quibot-dev/QuiBot_IA-3Dmechatronic/hardware/electronics/README.md

# Electrònica

Aquesta carpeta conté els esquemes elèctrics de Quibot, elaborats amb KiCad 10 i exportats també en PDF.

El prototip utilitza mòduls comercials i cablejat punt a punt. No s'ha dissenyat una PCB pròpia i, per tant, no hi ha fitxers Gerber.
