quibot-dev/QuiBot_IA-3Dmechatronic/hardware/Cad/STL/README.md

Aquí es troben els fitxers STL del conjunts del robot.
