quibot-dev/QuiBot_IA-3Dmechatronic/hardware/Cad/README.md

Aquí es troben els fitxers necessaris per la creació del robot.
