quibot-dev/QuiBot_IA-3Dmechatronic/docs/Imatges/Conjunts Robot.png

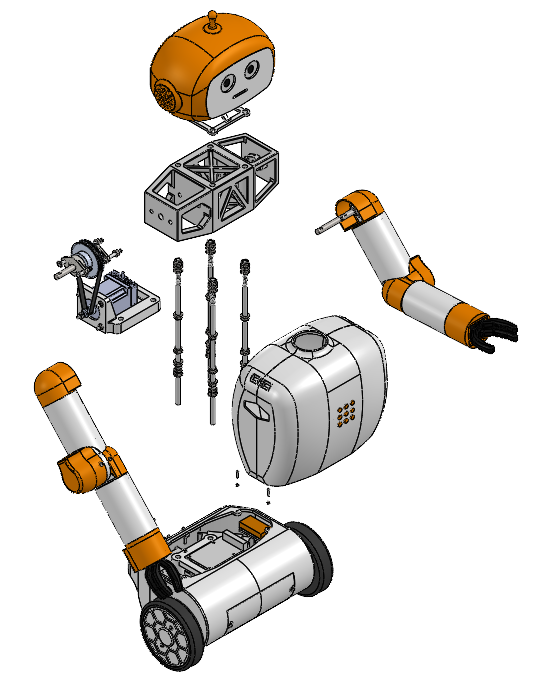
docs/Imatges/Conjunts Robot.png
