quibot-dev/QuiBot_IA-3Dmechatronic/bom/ Llista de materials de compra/Material de compra.csv

Categoria/Concepte | Quantitat | Cost unitari (€) | Cost Total (€) | Ref.
Processament i Control
Raspberry Pi 4 Model B 4 GB | 1 | 108,95 | 108,95 | https://www.tiendatec.es/raspberry-pi/gama-raspberry-pi/1100-raspberry-pi-4-modelo-b-4gb-5056561800349.html
MicroSD | 1 | 17,48 | 17,48 | https://www.amazon.es/-/en/SanDisk-Ultra-microSDHC-Adapter-100MB/dp/B08HVWJM8C
Arduino Uno Rev3 | 1 | 29,3 | 29,3 | https://www.amazon.es/Arduino-UNO-A000066-microcontrolador-ATmega328/dp/B008GRTSV6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
Sensors i Interfície
DualEye | 1 | 26,99 | 26,99 | https://www.amazon.es/-/en/Waveshare-Development-Resolution-Dual-Core-Processor/dp/B0FQ58T5VS
Mòdul de Micròfon (ReSpeaker) | 1 | 31,11 | 31,11 | https://www.mouser.es/ProductDetail/Seeed-Studio/110061601?qs=efUn273yAhcPxUjBpI0kHA%3D%3D&mgh=1&vip=1
Altaveu | 1 | 9,99 | 9,99 | https://www.amazon.es/Digitalkey-completo-pulgadas-cuadrado-frecuencia/dp/B0GL36Q9HS
Motors
Stepper Nema 23 | 1 | 31,22 | 31,22 | https://www.amazon.es/STEPPERONLINE-Nema-23-Motor-bipolar/dp/B00PNEPI0A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
Stepper Nema 17 | 2 | 16,94 | 33,88 | https://www.amazon.es/Stepper-Bipolar-4-lead-Printer-STEPPERONLINE/dp/B00PNEQKC0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
Servomotor 15kg·cm | 1 | 45,97 | 45,97 | https://www.amazon.es/ANNIMOS-Direcci%C3%B3n-Digital-Engranaje-Inoxidable/dp/B0C69BXL6V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
Servomotor 15Kg·cm (2u.) | 1 | 15,99 | 15,99 | https://www.amazon.es/Miuzei-Servomotor-Accuracy-Airplane-Helicopter/dp/B0C1TXW74L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
Drivers i Distribució de Potència
Driver Steppers (TB6600) | 3 | 10,89 | 32,67 | https://www.amazon.es/COVVY-TB6600-Controlador-segmentos-Conductor/dp/B07SBZ9SM5
Placa de distribució (PDB) | 1 | 23,59 | 23,59 | https://rc-innovations.es/shop/fchub-12s-placa-potencia-xclass-matek-fchub-12s-v2-440a-bec-5v-12v-11108
Convertidor Buck (Arduino i servos) | 2 | 5,99 | 11,98 | https://www.amazon.es/XL4015-Convertidor-ajustable-CC-CV/dp/B0D9HPY6J6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
UBEC servo | 1 | 18,79 | 18,79 | https://es.aliexpress.com/item/1005008564508622.html?src=google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
Alimentació
Bateria | 1 | 49,99 | 49,99 | https://www.amazon.es/DXF-14-8V-Bater%C3%ADa-6500mah-Conector/dp/B09KP6T2RC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
Carregador bateria | 1 | 36,99 | 36,99 | https://www.amazon.es/Cargador-bater%C3%ADa-B6-Adaptador-Plomo-%C3%A1cido/dp/B0F2H3XR6S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
Alarma bateria | 1 | 6,99 | 6,99 | https://www.amazon.es/QC-Battery-Monitor-Zumbador-indicador/dp/B077Z1N9CS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
Cablejat i Protecció
Cable AWG16 | 1 | 12,99 | 12,99 | https://www.amazon.es/Silicona-Alambres-El%C3%A9ctricos-Conductor-paralelo/dp/B07QJFRYT8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
Cable AWG18 | 1 | 19,79 | 19,79 | https://www.amazon.es/MMOBIEL-AWG-Cable-El%C3%A9ctrico-Paralelo/dp/B0DGV6793J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
Cable AWG24 | 1 | 8,99 | 8,99 | https://www.amazon.es/URCIANOW-El%C3%A9ctrico-Conductores-trenzado-esta%C3%B1ado/dp/B0CH9X7X6L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
Cable Dupont (mascle-femella) | 3 | 6,5 | 19,5 | https://www.amazon.es/TECHZOCO-alambre-Prototipo-Raspberry-Breadboard/dp/B0DLR85XS5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
Cable USB-A a USB-C (1m) | 2 | 7,8 | 15,6 | https://www.amazon.es/deleyCON-USB-USB-C-Cable-5Gbps/dp/B0GVKJJ3QN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
Cable USB-A a USB-B (1m) | 1 | 6,95 | 6,95 | https://www.amazon.es/deleyCON-Printer-Printers-Scanners-Braided/dp/B0DGW5V48J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
Cable d’alimentació Raspberry | 1 | 3,97 | 3,97 | https://www.reichelt.com/es/es/shop/producto/raspberry_pi_-_cable_de_alimentacion_usb-c_max_5_a_1_m-405496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
Fusible | 1 | 0,5 | 0,5 | *
Portafusibles | 1 | 3 | 3 | *
Terminal Faston | 2 | 1 | 2 | *
Concepte | Quantitat | Preu unitari (€) | Import (€) | Ref.
Transmissió i Moviment
Rodament 40x52x7mm | 1 | 10,09 | 10,09 | https://www.amazon.es/dp/B0CL4XF6HH?aref=ggrQ3vEDTD&sp_csd=d2lkZ2V0TmFtZT1zcF9kZXRhaWxfdGhlbWF0aWM
Rodament amb brida (2u.) | 1 | 11,51 | 11,51 | https://www.amazon.es/Rodamientos-Cojinetes-Cojinete-Maquinaria-Transporte/dp/B0DJ3G4DZ4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
Politja GT2 20D (Ø int. 6,35mm) | 1 | 6,47 | 6,47 | https://www.amazon.es/Alamor-Sincronizaci%C3%B3n-20Teeth-Di%C3%A1metro-Impresora/dp/B076P75NGK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
Politja GT2 100D (Ø int. 10mm) | 1 | 26,62 | 26,62 | https://www.amazon.es/dentada-distribuci%C3%B3n-di%C3%A1metro-s%C3%ADncrona-impresora/dp/B0D3CDWB7C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
Corretja GT2 10mm, 348mm | 1 | 8,49 | 8,49 | https://www.amazon.es/Turmberg3D-Correa-dentada-cerrada-GT2/dp/B09B2GK13C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
Eix 10x100mm | 1 | 7 | 7 | https://www.amazon.es/unidades-horizontal-precisi%C3%B3n-rodamiento-redonda/dp/B0D2L12GW6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
Rodes Giratòries Autoadhesives | 1 | 6,99 | 6,99 | https://www.amazon.es/Flintronic-Giratorias-Autoadhesivas-Tornillos-Adhesivos/dp/B0DXB4NJPG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
Cargoleria i Fixació
Acoblament 10mm | 1 | 1,25 | 1,25 | https://handsontec.com/index.php/product/shf10-horizontal-linear-shaft-holder/
Acoblament brida 10 mm | 1 | 11,99 | 11,99 | https://www.amazon.es/dp/B0FXR72L42?smid=A3KRCRBQV8XOTV&ref_=chk_typ_imgToDp&th=1
Acoblament rodes | 2 | 8,49 | 16,98 | https://www.amazon.es/dp/B09XMC7YMY/ref=cm_cr_arp_d_btm?ie=UTF8
Barra roscada M8 x 300 mm( 4u.) | 1 | 15,99 | 15,99 | https://www.amazon.es/Varilla-Roscada-Acero-Inoxidable-M8x300mm/dp/B0H9S17NXH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
Paquet d’Inserts de Llautó | 1 | 31,99 | 31,99 | https://www.amazon.es/dp/B0FQ2J8FX7?aref=3WEpV6r98c&sp_csd=d2lkZ2V0TmFtZT1zcF9kZXRhaWw
Cargols (Assortiment genèric) | 1 | 14,99 | 14,99 | https://www.amazon.es/tornillos-hexagonales-arandelas-roscados-Phillips/dp/B0B42DJPHZ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
Cargols M3 x 25mm | 1 | 6,99 | 6,99 | https://www.amazon.es/Tornillos-M3-Hexagonal-Cil%C3%ADndricaTornillos-Inoxidable/dp/B0F8R4RT7N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
Cargols de ressalt 4 x 45 x M3 x 0,5 | 1 | 13,07 | 13,07 | https://www.amazon.es/sourcing-map-inoxidable-industrias-maquinaria/dp/B0FDQ919CL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
Femelles M8 | 1 | 9,59 | 9,59 | https://www.amazon.es/GUEEYUAW-Piezas-Tuercas-Hexagonales-Inoxidable/dp/B0FHBH3MD1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
Femelles autoblocants M8 | 1 | 11,9 | 11,9 | https://www.amazon.es/dp/B0FV3MFBQG?ref=ppx_yo2ov_dt_b_fed_asin_title
Materials de Fabricació i Consumibles
Filament 3D | 5 kg | 29/kg | 145 | https://bcn3d.com/es/producto/pla-bcn3d-filamentos-2/
Estany per soldar | 1 | 10,99 | 10,99 | https://www.amazon.es/HUAREW-HR990307-alambre-soldadura-colofonia/dp/B08CRNHLKV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
Cinta rodes | 1 | 15,39 | 15,39 | *
Total | 897,04
