quibot-dev/QuiBot_IA-3Dmechatronic/bom/ Llista de materials de compra/Material_de_compra.csv

Categoria/Concepte | Quantitat | Cost unitari (€) | Cost Total (€) | Ref.
Processament i Control
Raspberry Pi 4 Model B 4 GB | 1 | 108,95 | 108,95 | Link
MicroSD | 1 | 17,48 | 17,48 | Link
Arduino Uno Rev3 | 1 | 29,3 | 29,3 | Link
Sensors i Interfície
DualEye | 1 | 26,99 | 26,99 | Link
Mòdul de Micròfon (ReSpeaker) | 1 | 31,11 | 31,11 | Link
Altaveu | 1 | 9,99 | 9,99 | Link
Motors
Stepper Nema 23 | 1 | 31,22 | 31,22 | Link
Stepper Nema 17 | 2 | 16,94 | 33,88 | Link
Servomotor 15kg·cm | 1 | 45,97 | 45,97 | Link
Servomotor 15Kg·cm (2u.) | 1 | 15,99 | 15,99 | Link
Drivers i Distribució de Potència
Driver Steppers (TB6600) | 3 | 10,89 | 32,67 | Link
Placa de distribució (PDB) | 1 | 23,59 | 23,59 | Link
Convertidor Buck (Arduino i servos) | 2 | 5,99 | 11,98 | Link
UBEC servo | 1 | 18,79 | 18,79 | Link
Alimentació
Bateria | 1 | 49,99 | 49,99 | Link
Carregador bateria | 1 | 36,99 | 36,99 | Link
Alarma bateria | 1 | 6,99 | 6,99 | Link
Cablejat i Protecció
Cable AWG16 | 1 | 12,99 | 12,99 | Link
Cable AWG18 | 1 | 19,79 | 19,79 | Link
Cable AWG24 | 1 | 8,99 | 8,99 | Link
Cable Dupont (mascle-femella) | 3 | 6,5 | 19,5 | Link
Cable USB-A a USB-C (1m) | 2 | 7,8 | 15,6 | Link
Cable USB-A a USB-B (1m) | 1 | 6,95 | 6,95 | Link
Cable d’alimentació Raspberry | 1 | 3,97 | 3,97 | Link
Fusible | 1 | 0,5 | 0,5 | *
Portafusibles | 1 | 3 | 3 | *
Terminal Faston | 2 | 1 | 2 | *
Concepte | Quantitat | Preu unitari (€) | Import (€) | Ref.
Transmissió i Moviment
Rodament 40x52x7mm | 1 | 10,09 | 10,09 | Link
Rodament amb brida (2u.) | 1 | 11,51 | 11,51 | Link
Politja GT2 20D (Ø int. 6,35mm) | 1 | 6,47 | 6,47 | Link
Politja GT2 100D (Ø int. 10mm) | 1 | 26,62 | 26,62 | Link
Corretja GT2 10mm, 348mm | 1 | 8,49 | 8,49 | Link
Eix 10x100mm | 1 | 7 | 7 | Link
Rodes Giratòries Autoadhesives | 1 | 6,99 | 6,99 | Link
Cargoleria i Fixació
Acoblament 10mm | 1 | 1,25 | 1,25 | Link
Acoblament brida 10 mm | 1 | 11,99 | 11,99 | Link
Acoblament rodes | 2 | 8,49 | 16,98 | Link
Barra roscada M8 x 300 mm( 4u.) | 1 | 15,99 | 15,99 | Link
Paquet d’Inserts de Llautó | 1 | 31,99 | 31,99 | Link
Cargols (Assortiment genèric) | 1 | 14,99 | 14,99 | Link
Cargols M3 x 25mm | 1 | 6,99 | 6,99 | Link
Cargols de ressalt 4 x 45 x M3 x 0,5 | 1 | 13,07 | 13,07 | Link
Femelles M8 | 1 | 9,59 | 9,59 | Link
Femelles autoblocants M8 | 1 | 11,9 | 11,9 | Link
Materials de Fabricació i Consumibles
Filament 3D | 5 kg | 29/kg | 145 | PLA Filamento - BCN3D
Estany per soldar | 1 | 10,99 | 10,99 | Link
Cinta rodes | 1 | 15,39 | 15,39 | *
Total | 897,04
