quibot-dev/QuiBot_IA-3Dmechatronic/hardware/Cad/Step/Cos definitiu derrere.STEP

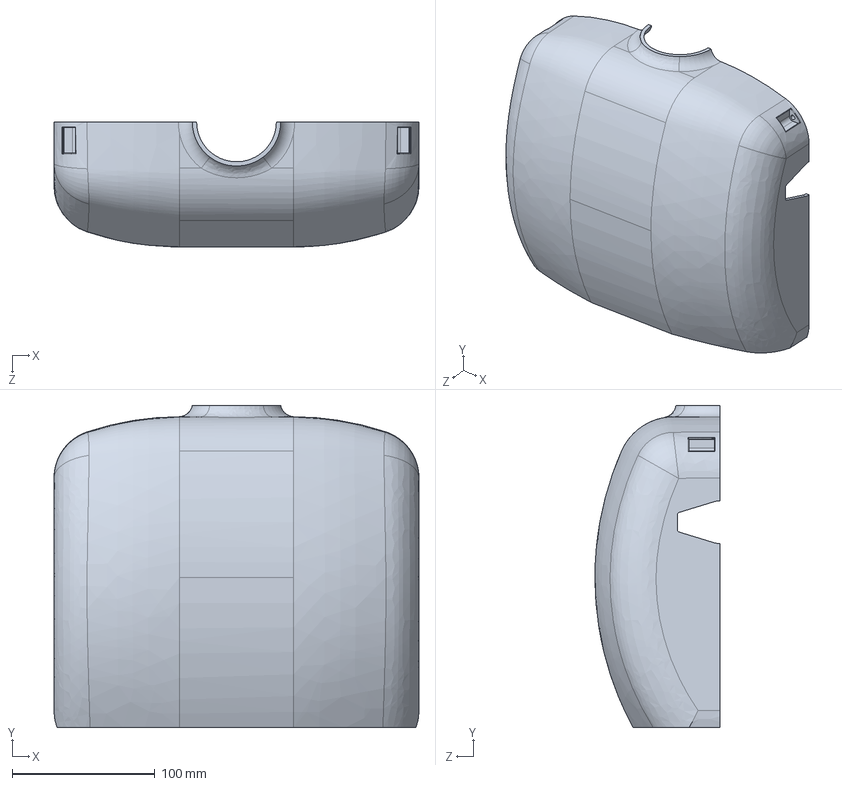
[picture p3: CAD file, 2026-10-04]
hardware/Cad/Step/Cos definitiu derrere.STEP
256.0 x 226.0 x 87.8 mm
