quibot-dev/QuiBot_IA-3Dmechatronic/hardware/Cad/Step/Roda.STEP

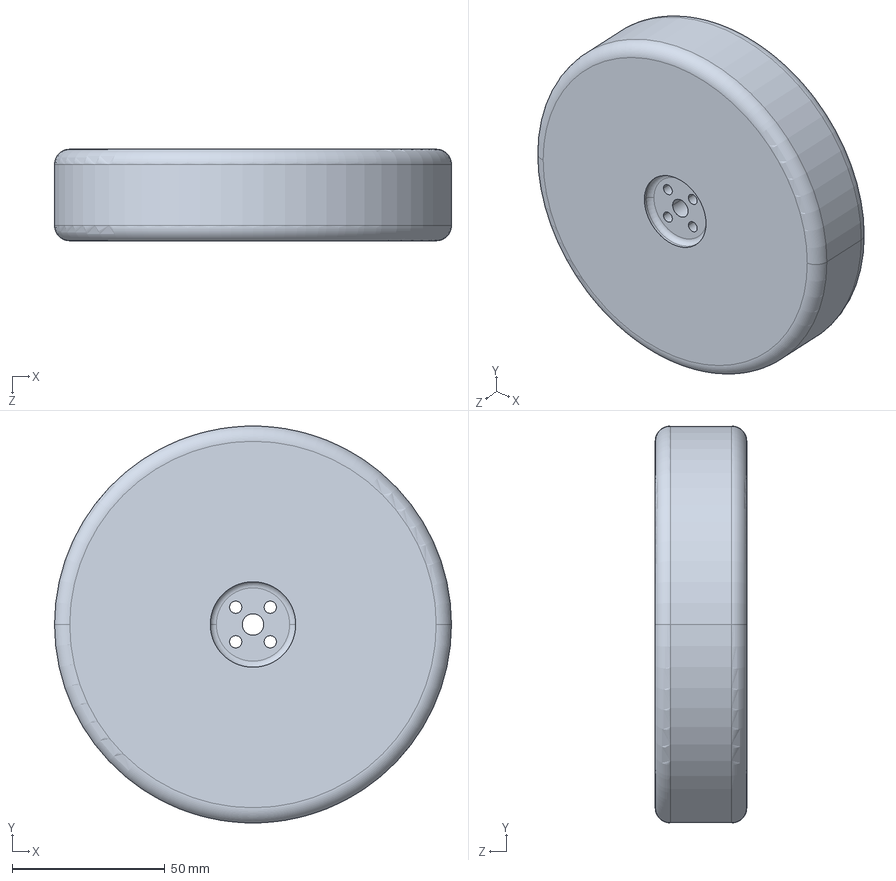
[picture p4: CAD file, 2026-10-04]
hardware/Cad/Step/Roda.STEP
130.0 x 129.9 x 30.0 mm
