quibot-dev/QuiBot_IA-3Dmechatronic/hardware/Cad/Step/Símbol upc.STEP

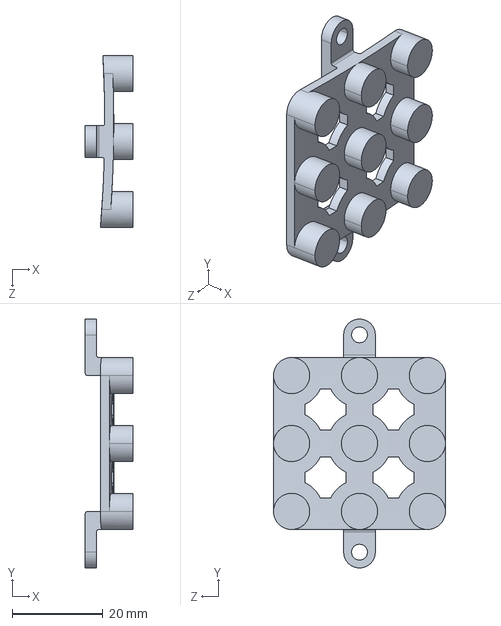
[picture p5: CAD file, 2026-10-04]
hardware/Cad/Step/Símbol upc.STEP
10.5 x 55.0 x 38.0 mm
