quibot-dev/QuiBot_IA-3Dmechatronic/hardware/Cad/Step/Base definitiva.STEP

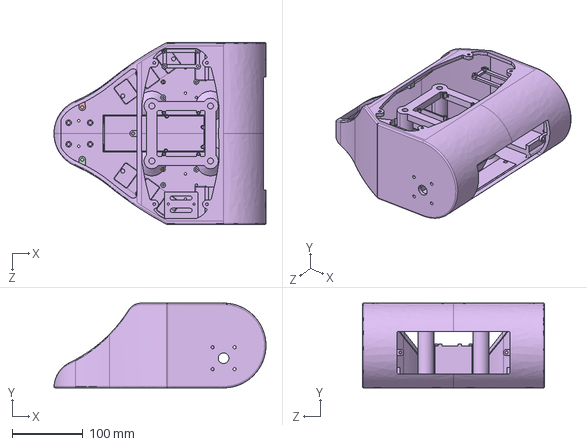
[picture p6: CAD file, 2026-10-04]
hardware/Cad/Step/Base definitiva.STEP
299.9 x 120.0 x 258.0 mm
