quibot-dev/QuiBot_IA-3Dmechatronic/hardware/Cad/Step/Primera tapa base.STEP

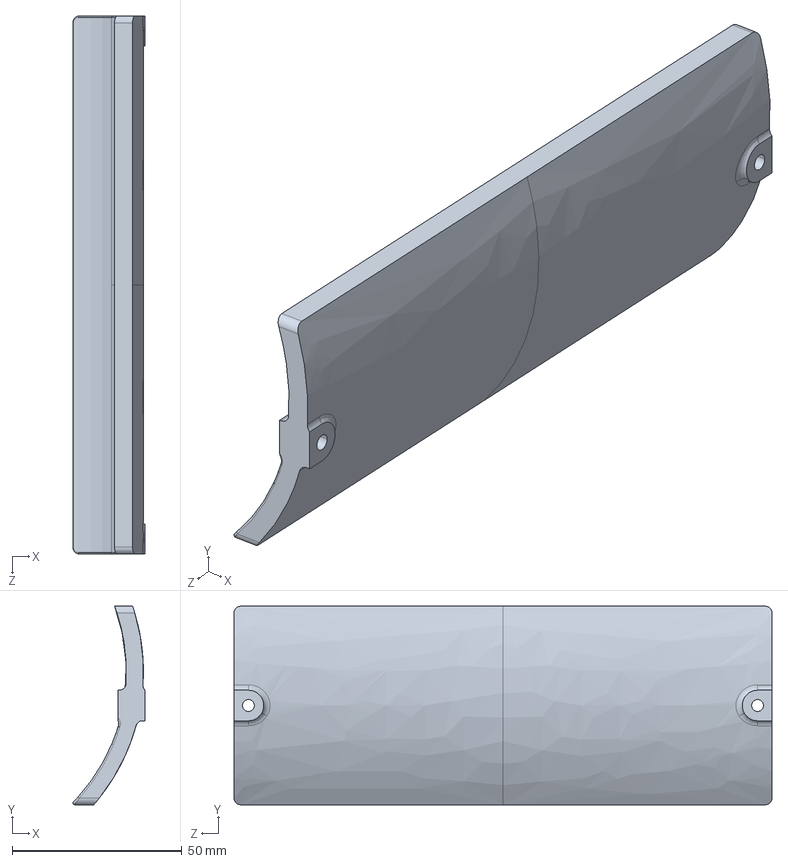
[picture p7: CAD file, 2026-10-04]
hardware/Cad/Step/Primera tapa base.STEP
21.3 x 58.5 x 158.5 mm
