quibot-dev/QuiBot_IA-3Dmechatronic/hardware/Cad/Step/Tapa_Roda.STEP

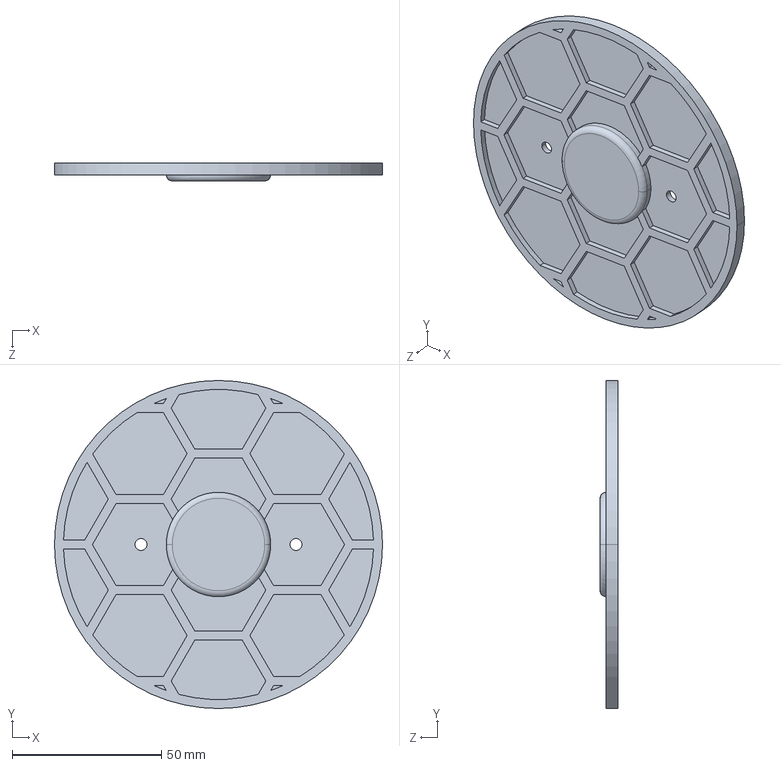
[picture p8: CAD file, 2026-10-04]
hardware/Cad/Step/Tapa_Roda.STEP
110.0 x 110.0 x 6.00 mm
