quibot-dev/QuiBot_IA-3Dmechatronic/hardware/Cad/Step/Cara.STEP

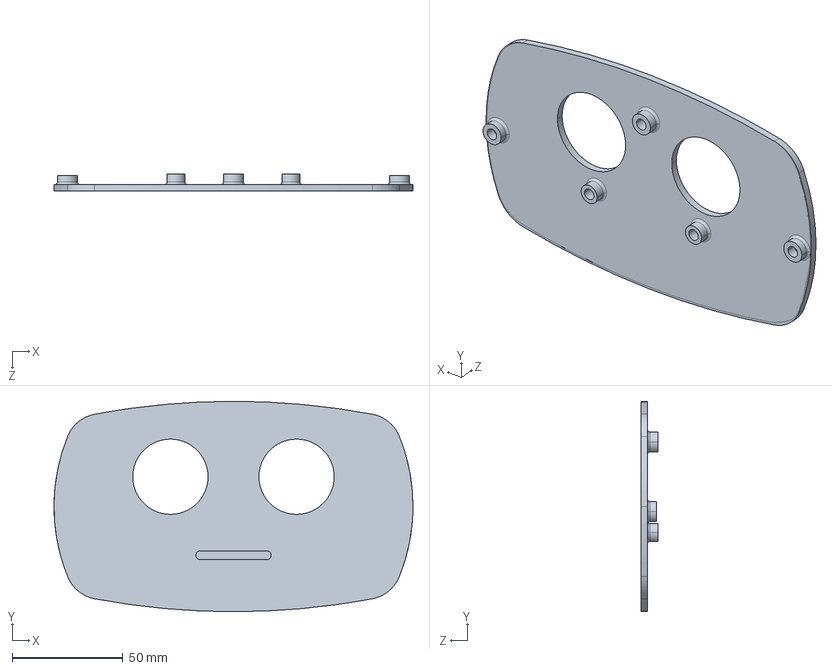
[picture p9: CAD file, 2026-10-04]
hardware/Cad/Step/Cara.STEP
162.2 x 95.0 x 7.71 mm
