quibot-dev/QuiBot_IA-3Dmechatronic/hardware/Cad/Step/Cap rectificat.STEP

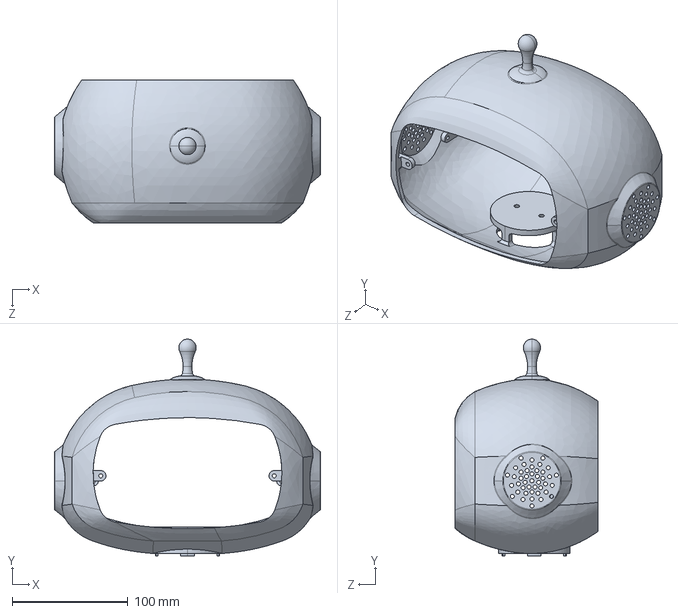
[picture p10: CAD file, 2026-10-04]
hardware/Cad/Step/Cap rectificat.STEP
230.0 x 187.5 x 123.4 mm
