quibot-dev/QuiBot_IA-3Dmechatronic/hardware/Cad/Step/Tapa posterior.STEP

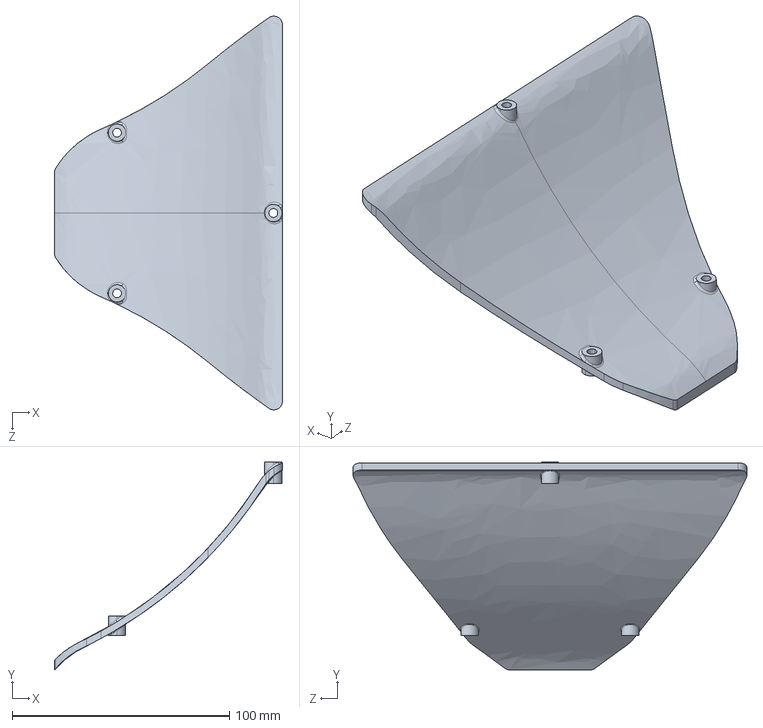
[picture p12: CAD file, 2026-10-04]
hardware/Cad/Step/Tapa posterior.STEP
105.0 x 95.8 x 181.3 mm
