quibot-dev/QuiBot_IA-3Dmechatronic/hardware/Cad/Step/Suport ulls.STEP

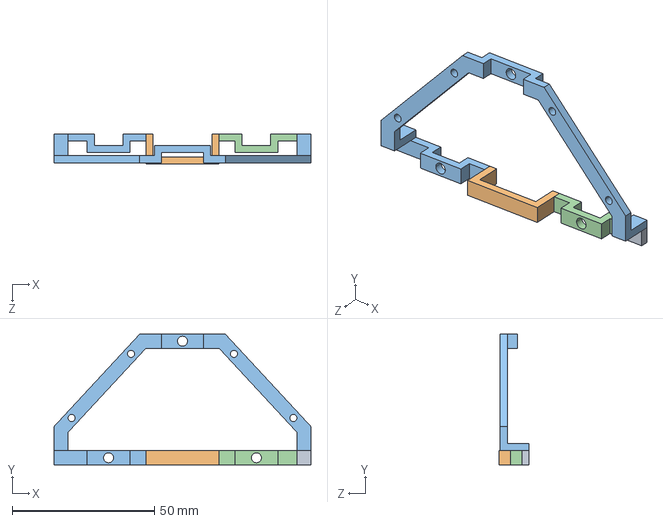
[picture p13: CAD file, 2026-10-04]
hardware/Cad/Step/Suport ulls.STEP
90.4 x 46.0 x 10.5 mm
