quibot-dev/QuiBot_IA-3Dmechatronic/hardware/Cad/Step/Suport cap.STEP

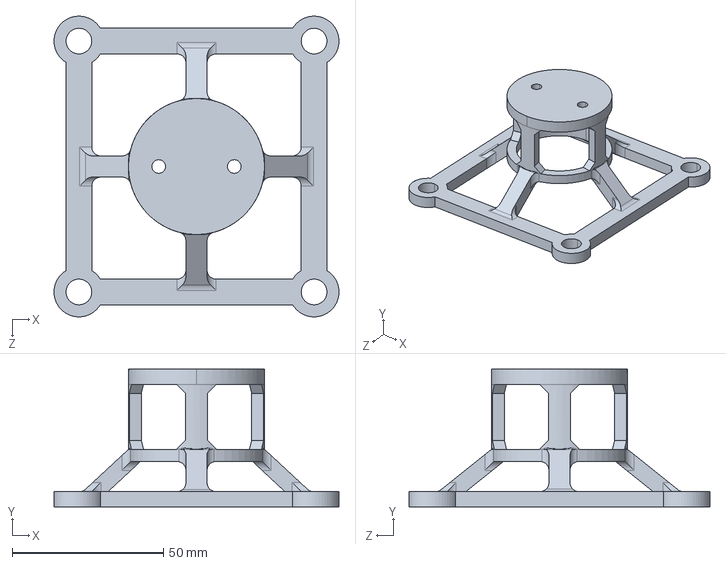
[picture p14: CAD file, 2026-10-04]
hardware/Cad/Step/Suport cap.STEP
94.3 x 45.5 x 99.5 mm
