quibot-dev/QuiBot_IA-3Dmechatronic/hardware/Cad/Step/Tapa posterior cap.STEP

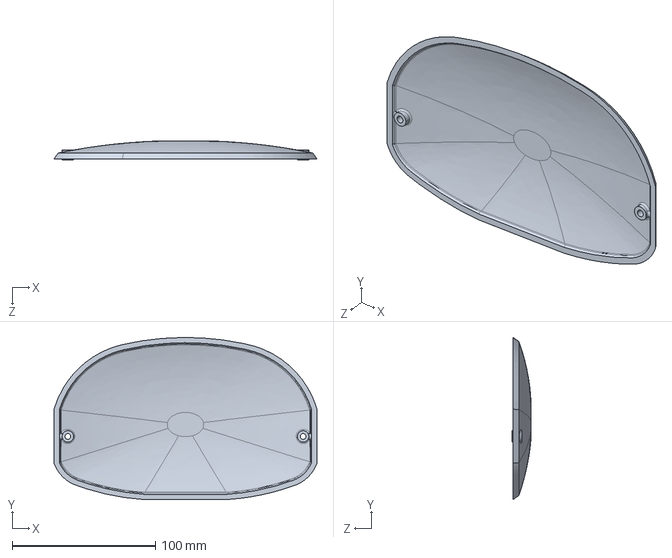
[picture p15: CAD file, 2026-10-04]
hardware/Cad/Step/Tapa posterior cap.STEP
183.3 x 113.0 x 13.6 mm
