quibot-dev/QuiBot_IA-3Dmechatronic/hardware/Cad/Step/Pinça interior braç esquerre.STEP

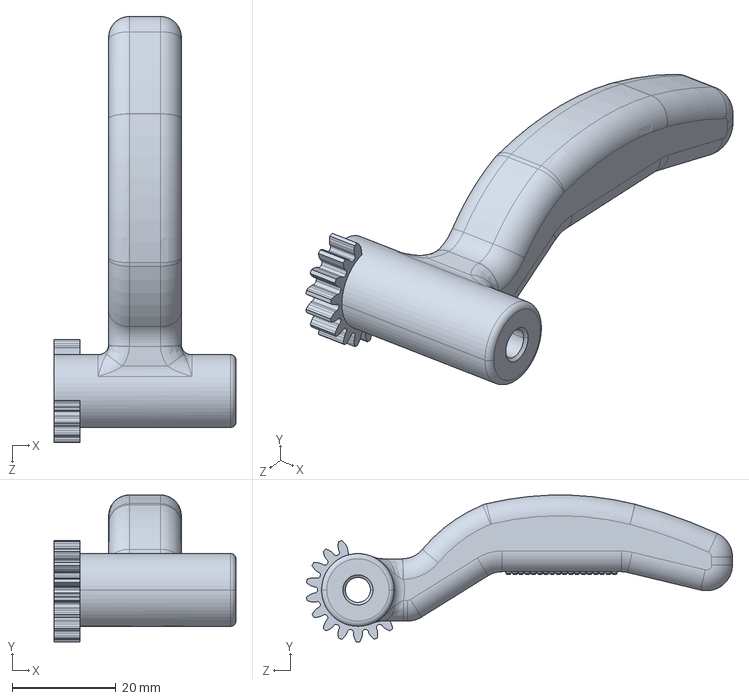
[picture p16: CAD file, 2026-10-04]
hardware/Cad/Step/Pinça interior braç esquerre.STEP
35.0 x 28.2 x 82.0 mm
