quibot-dev/QuiBot_IA-3Dmechatronic/hardware/Cad/Step/Colze interior esquerre.STEP

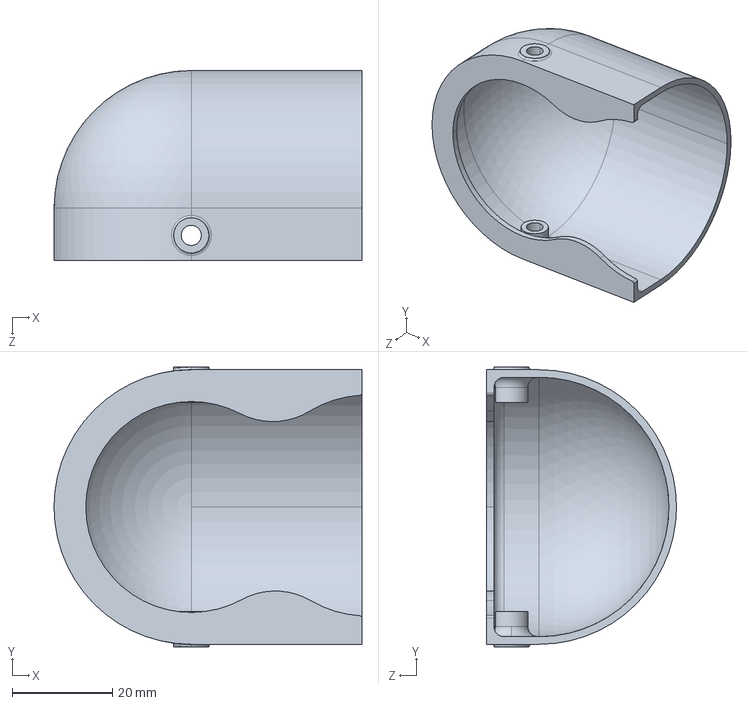
[picture p17: CAD file, 2026-10-04]
hardware/Cad/Step/Colze interior esquerre.STEP
61.3 x 55.7 x 37.8 mm
