quibot-dev/QuiBot_IA-3Dmechatronic/hardware/Cad/Step/Pinça exterior braç esquerre.STEP

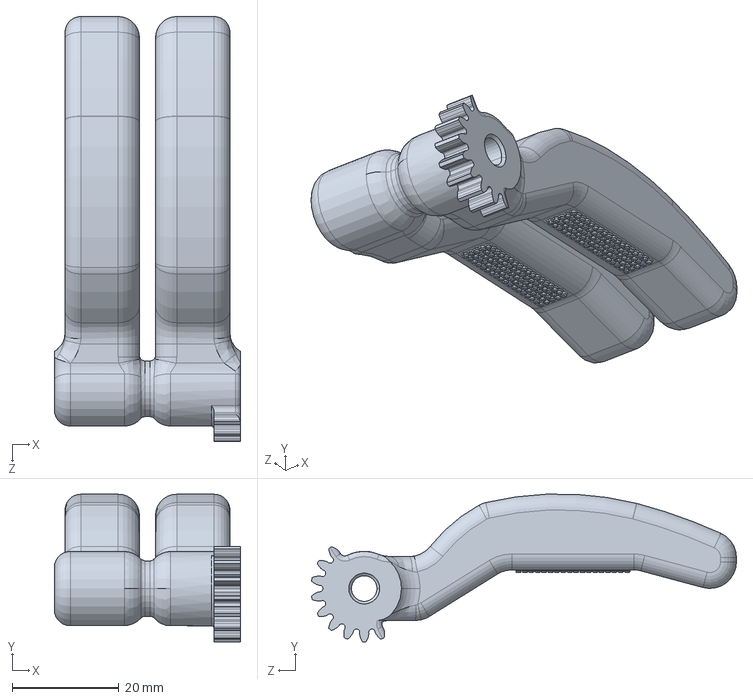
[picture p18: CAD file, 2026-10-04]
hardware/Cad/Step/Pinça exterior braç esquerre.STEP
35.0 x 27.7 x 79.8 mm
