quibot-dev/QuiBot_IA-3Dmechatronic/hardware/Cad/Step/Suport interior braços.STEP

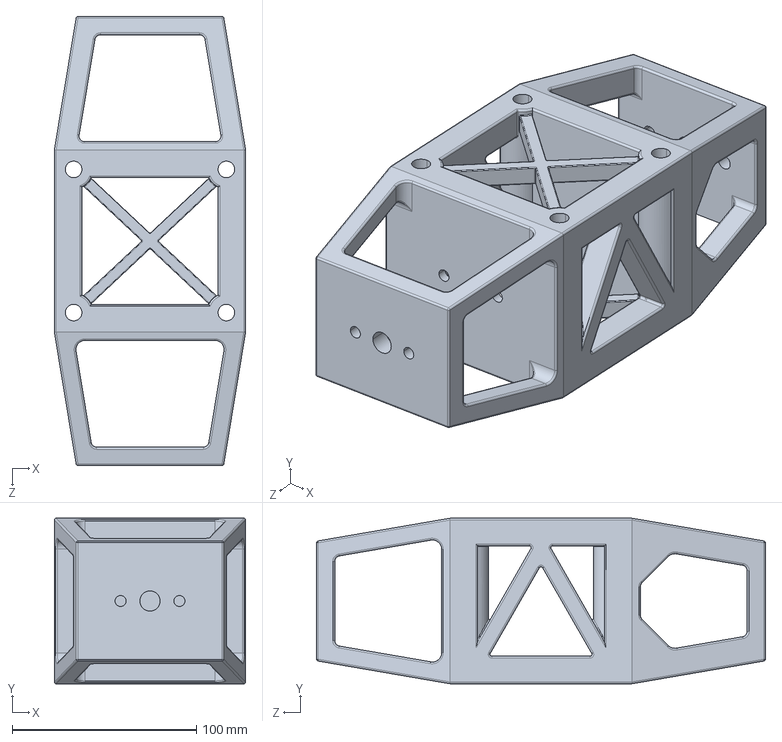
[picture p19: CAD file, 2026-10-04]
hardware/Cad/Step/Suport interior braços.STEP
104.0 x 90.0 x 244.0 mm
