quibot-dev/QuiBot_IA-3Dmechatronic/hardware/Cad/Step/Antebrazo braç esquerre.STEP

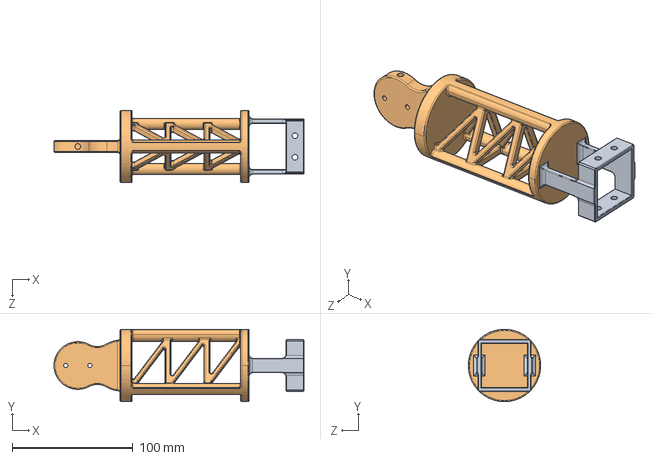
[picture p20: CAD file, 2026-10-04]
hardware/Cad/Step/Antebrazo braç esquerre.STEP
207.2 x 60.0 x 60.0 mm
