quibot-dev/QuiBot_IA-3Dmechatronic/hardware/Cad/Step/Tub principal braç esquerre.STEP

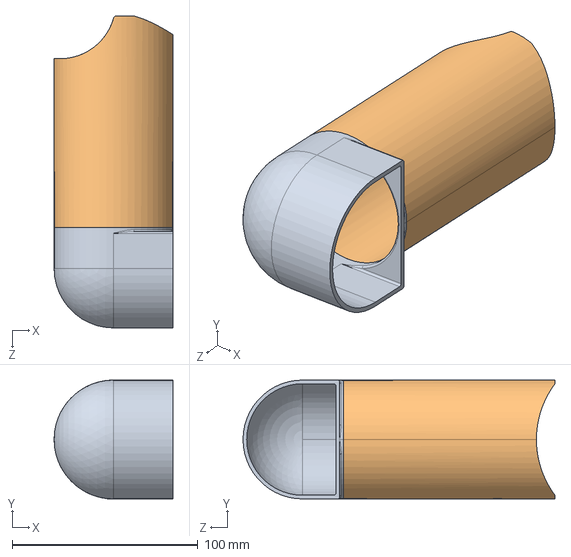
[picture p21: CAD file, 2026-10-04]
hardware/Cad/Step/Tub principal braç esquerre.STEP
64.0 x 64.0 x 168.0 mm
