quibot-dev/QuiBot_IA-3Dmechatronic/hardware/Cad/Step/Colze braç esquerre definitiu.STEP

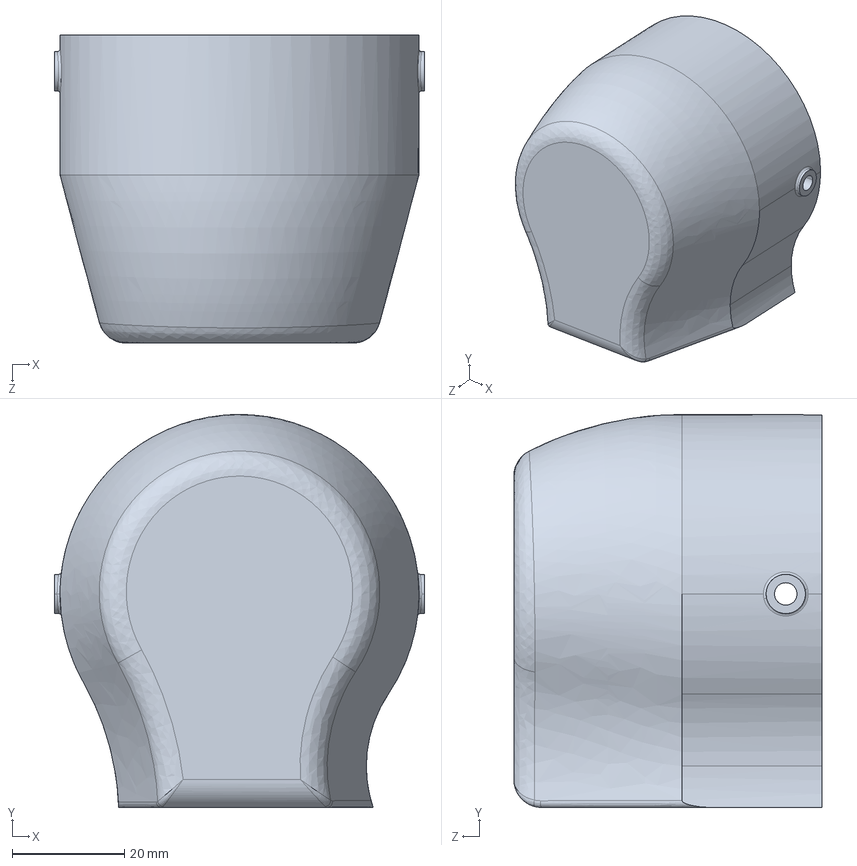
[picture p22: CAD file, 2026-10-04]
hardware/Cad/Step/Colze braç esquerre definitiu.STEP
66.0 x 70.1 x 55.0 mm
