quibot-dev/QuiBot_IA-3Dmechatronic/hardware/Cad/Step/Tub avantbraç braç esquerre.STEP

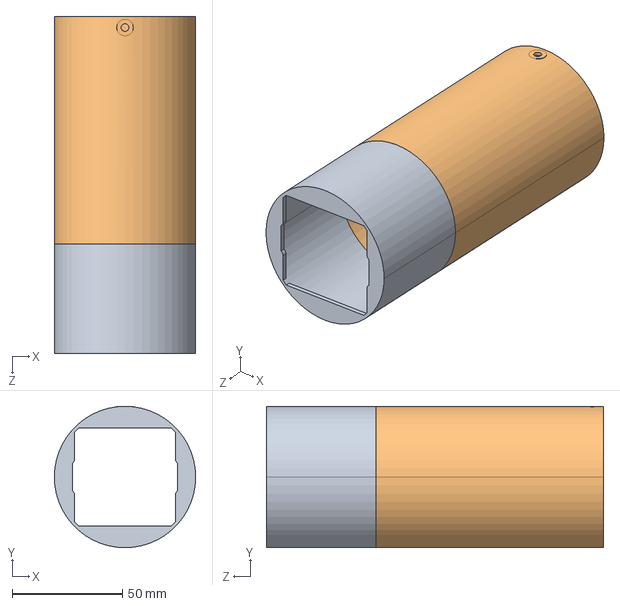
[picture p23: CAD file, 2026-10-04]
hardware/Cad/Step/Tub avantbraç braç esquerre.STEP
64.0 x 64.0 x 152.5 mm
