quibot-dev/QuiBot_IA-3Dmechatronic/hardware/Cad/Step/Estructura principal braç esquerre.STEP

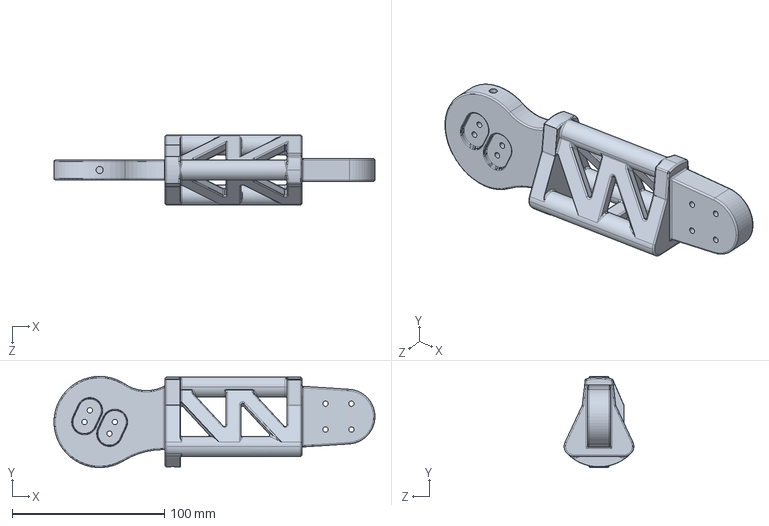
[picture p24: CAD file, 2026-10-04]
hardware/Cad/Step/Estructura principal braç esquerre.STEP
211.0 x 60.0 x 45.9 mm
