quibot-dev/QuiBot_IA-3Dmechatronic/hardware/Cad/Step/Avantbraç.STEP

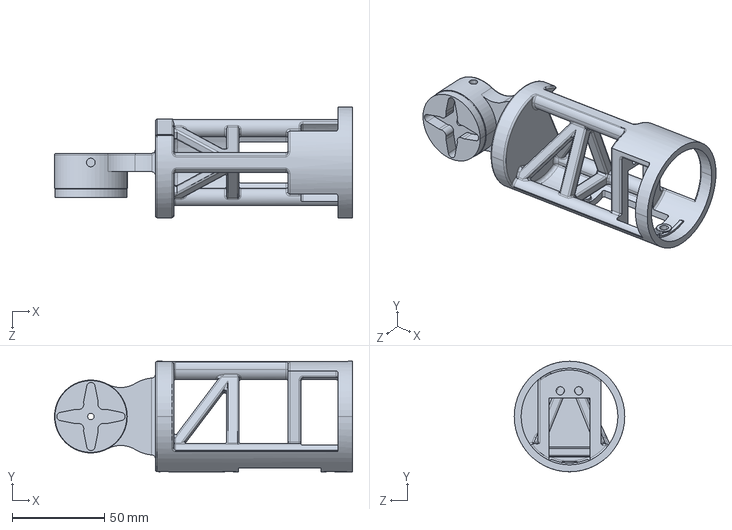
[picture p25: CAD file, 2026-10-04]
hardware/Cad/Step/Avantbraç.STEP
161.8 x 60.0 x 60.0 mm
