quibot-dev/QuiBot_IA-3Dmechatronic/hardware/Cad/Step/Tub canell.STEP

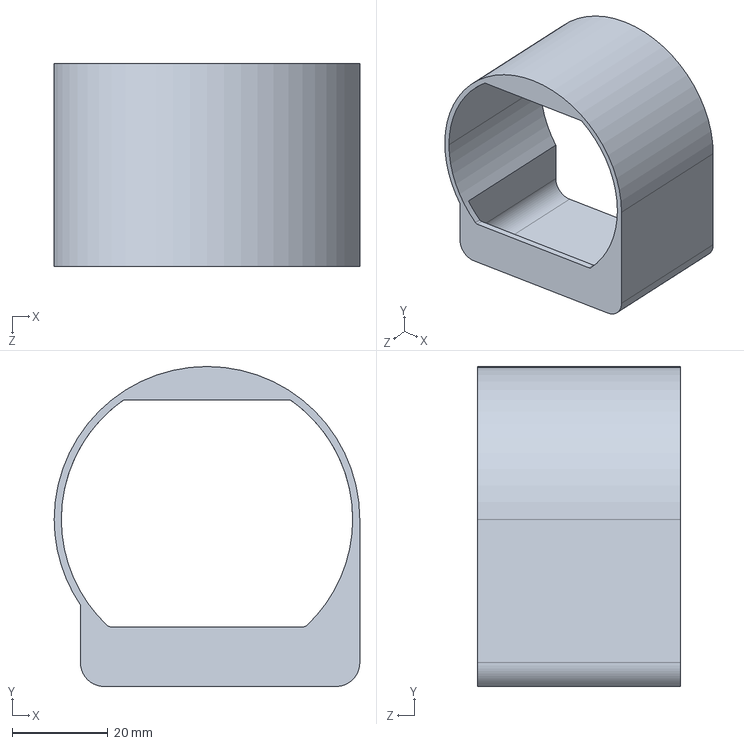
[picture p26: CAD file, 2026-10-04]
hardware/Cad/Step/Tub canell.STEP
64.0 x 67.0 x 42.5 mm
