quibot-dev/QuiBot_IA-3Dmechatronic/hardware/Cad/Step/Suport Nema 23.STEP

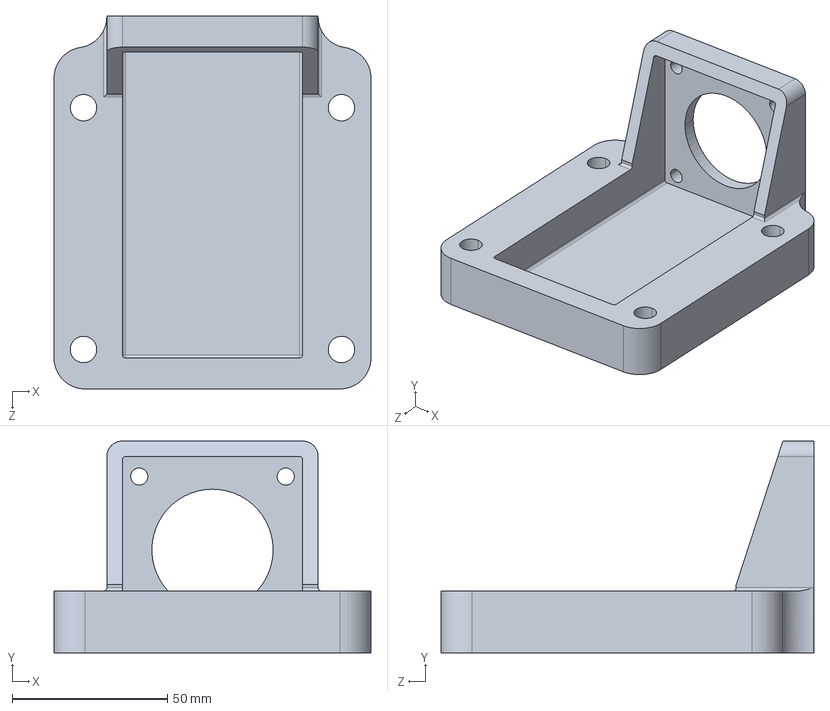
[picture p28: CAD file, 2026-10-04]
hardware/Cad/Step/Suport Nema 23.STEP
102.0 x 68.2 x 120.0 mm
