quibot-dev/QuiBot_IA-3Dmechatronic/hardware/Cad/Step/Tub antebrazo.STEP

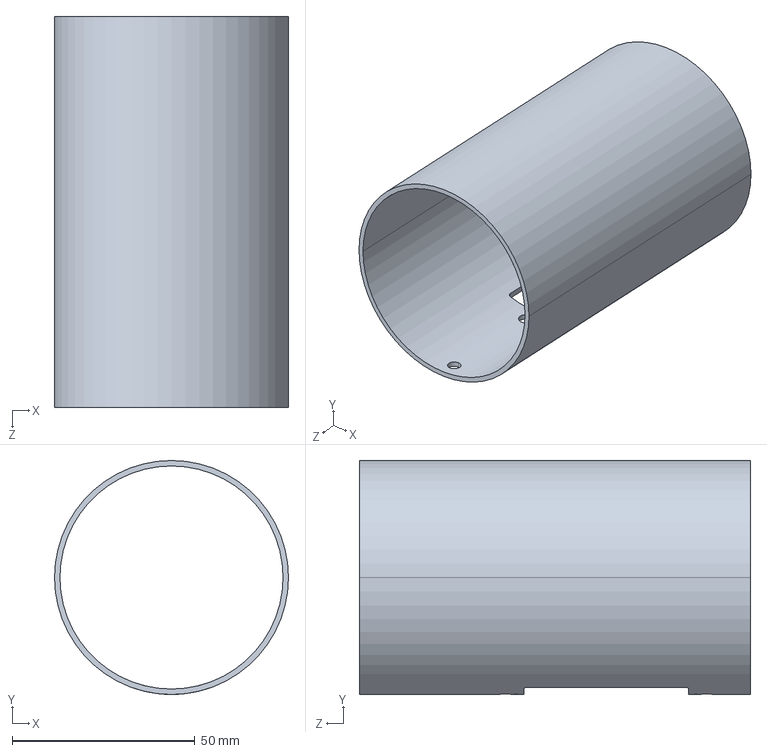
[picture p29: CAD file, 2026-10-04]
hardware/Cad/Step/Tub antebrazo.STEP
64.0 x 64.0 x 107.0 mm
