quibot-dev/QuiBot_IA-3Dmechatronic/hardware/Cad/Step/Canell dret.STEP

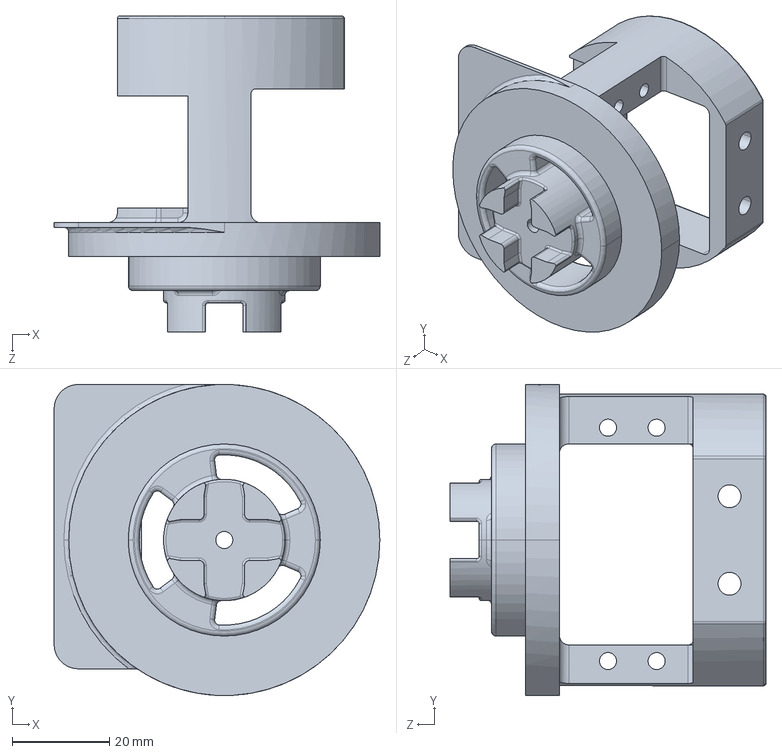
[picture p30: CAD file, 2026-10-04]
hardware/Cad/Step/Canell dret.STEP
67.0 x 64.0 x 65.0 mm
