quibot-dev/QuiBot_IA-3Dmechatronic/hardware/Cad/Step/Tapa servo canell.STEP

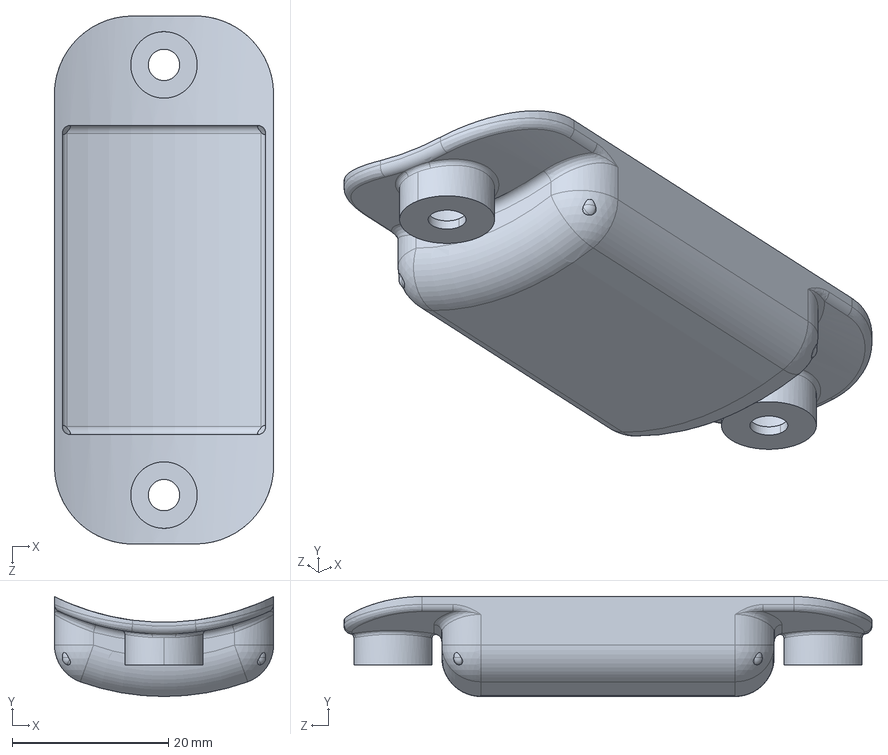
[picture p31: CAD file, 2026-10-04]
hardware/Cad/Step/Tapa servo canell.STEP
28.0 x 12.8 x 67.5 mm
