quibot-dev/QuiBot_IA-3Dmechatronic/docs/Imatges/1. Robot.SLDASM

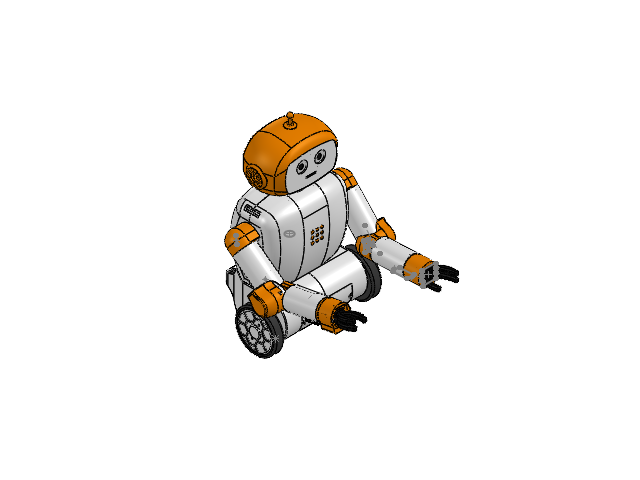
[picture p32: CAD file, 2026-10-04]
docs/Imatges/1. Robot.SLDASM
Base definitiva
Bateria
Roda_boja x 3
Driver x 3
SM8B-SRSS-TB v1
Main Board
Cos motor nema 17 x 2
Raspberry Pi 4
Arduino unoo
Primera tapa base
Tapa posterior
Buck x 3
Acomplamiento brida 5mm rodes x 2
Roda x 2
Tapa_Roda x 2
Arandela plana M3 x 73
Tornillo m3 x 25mm x 16
Femella hexagonal M3 x 26
Protoboard
Tornillo m3 x 10mm x 8
Tornillo m3 x 14mm x 21
Shaft holder 10mm x 2
Suport interior braços
Arandela plana M5 x 14
Femella haxagonal M5 x 8
Tornillo m5 x 30mm x 4
Polea 20T 6.35mm
Polea 100T 10mm
Corretja GT2 10 ample
Eix 10x100mm x 2
Suport Coixinet x 2
Coixinet x 2
Stepper Nema 23
Suport Nema 23
Tornillo m5 x 20mm x 4
Servomotor Colze 45 Kg·cm
Estructura principal braç dret
Antebrazo
Cojinete 40 x 52 x 7mm x 2
Servo munyeca i gripper 15 kg·cm x 2
Canell dret
Horn servo pinces
Engranaje 22T m=1
Pinça dreta braç dret
Pinça esquerre braç dret
Tornillo Hombro M3 x 4 x 45mm x 4
Arandela plana M4 x 25
Tub braç principal
Colze braç esquerre 1
Horn
Colze interior
Cover servo canell
Tub antebrazo
Tub canell
Horn Servo 15kg
Acoplament de Brida 10mm Diàmetre x 2
Tornillo m3 x 6mm x 18
Tornillo m4 x 30mm x 2
Tornillo m4 x 10mm x 2
Femella hexagonal M4 x 4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
