quibot-dev/QuiBot_IA-3Dmechatronic/(list of files, cad)

Other CAD files:
hardware/Cad/Step/Colze interior.STEP
hardware/Cad/Step/Pinça dreta braç dret.STEP
hardware/Cad/Step/Colze braç esquerre 1.STEP
hardware/Cad/Step/Tub braç principal.STEP
hardware/Cad/Step/Pinça esquerre braç dret.STEP
hardware/Cad/STL/Antebrazo braç esquerre.STL
hardware/Cad/STL/Avantbraç.STL
hardware/Cad/STL/Base definitiva.STL
hardware/Cad/STL/Canell dret.STL
hardware/Cad/STL/Cap rectificat.STL
hardware/Cad/STL/Cara.STL
hardware/Cad/STL/Colze braç esquerre 1.STL
hardware/Cad/STL/Colze braç esquerre definitiu.STL
hardware/Cad/STL/Colze interior esquerre.STL
hardware/Cad/STL/Colze interior.STL
hardware/Cad/STL/Cos definitiu davant.STL
hardware/Cad/STL/Cos definitiu derrere.STL
hardware/Cad/STL/Estructura principal braç dret.STL
hardware/Cad/STL/Estructura principal braç esquerre.STL
hardware/Cad/STL/Pinça dreta braç dret.STL
hardware/Cad/STL/Pinça esquerre braç dret.STL
hardware/Cad/STL/Pinça exterior braç esquerre.STL
hardware/Cad/STL/Pinça interior braç esquerre.STL
hardware/Cad/STL/Primera tapa base.STL
hardware/Cad/STL/Roda.STL
hardware/Cad/STL/Suport Nema 23.STL
hardware/Cad/STL/Suport cap.STL
hardware/Cad/STL/Suport interior braços.STL
hardware/Cad/STL/Suport ulls.STL
hardware/Cad/STL/Símbol upc.STL
hardware/Cad/STL/Tapa posterior cap.STL
hardware/Cad/STL/Tapa posterior.STL
hardware/Cad/STL/Tapa servo canell.STL
hardware/Cad/STL/Tapa_Roda.STL
hardware/Cad/STL/Tub antebrazo.STL
hardware/Cad/STL/Tub avantbraç braç esquerre.STL
hardware/Cad/STL/Tub braç principal.STL
hardware/Cad/STL/Tub canell.STL
hardware/Cad/STL/Tub principal braç esquerre.STL
