quibot-dev/QuiBot_IA-3Dmechatronic/hardware/electronics/Esquemes_electrics_Quibot.pdf

# 5V_Raspberry_Pi GND_PWR NEMA23_A+

# STEP_NEMA23 GND_PWR

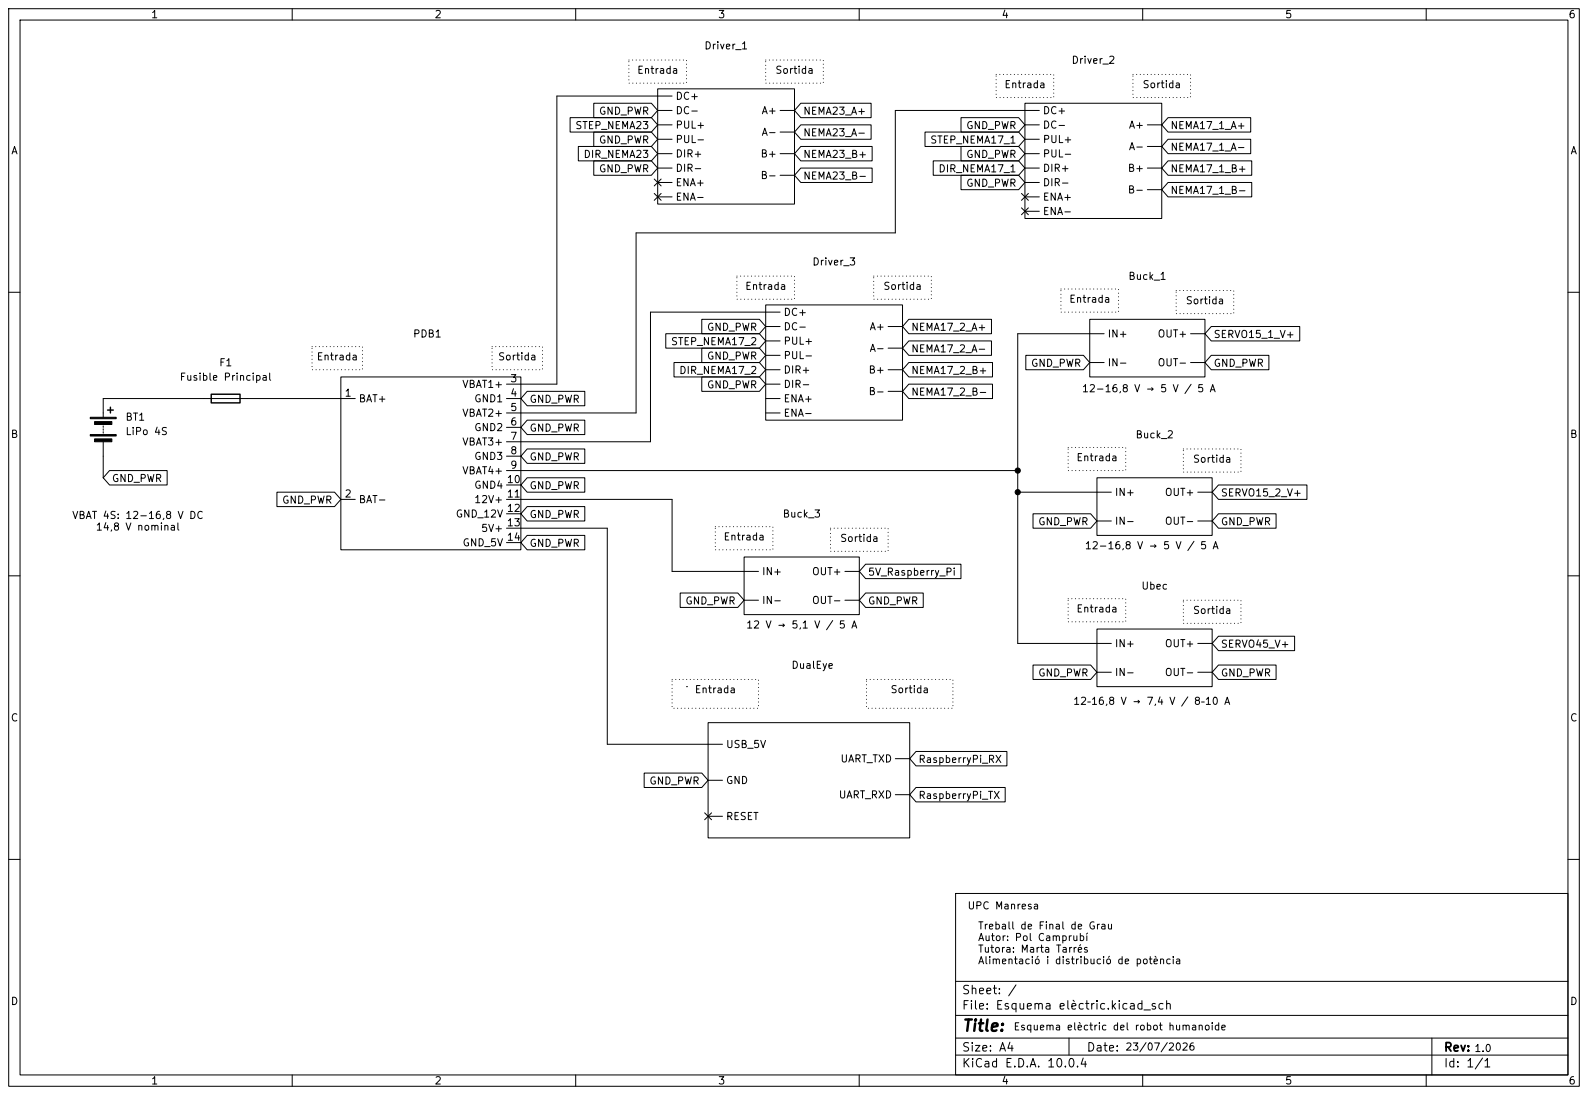
[picture p183: page 1]
D Date:; Size: A4; Rev:; BT1 LiPo 4S; Fusible Principal; Entrada; Sortida USB_5V GND; RESET; UART_TXD UART_RXD; DualEye Entrada; Sortida DC+; DC- PUL+ PUL- DIR+ DIR- ENA+ ENA-; Driver_3; Sortida; OUT+; OUT-; Buck_2; Ubec Entrada; Buck_3; Buck_1; Sortida BAT+ 1 BAT- 2; VBAT1+ 3 GND1 4; VBAT2+ 5 GND2 6; VBAT3+ 7 GND3 8; VBAT4+ 9 GND4 10; 12V+ 11 GND_12V 12; 5V+ 13 GND_5V 14 PDB1; Driver_1; Driver_2 GND_PWR; GND_PWR; SERVO45_V+; DIR_NEMA17_1; STEP_NEMA17_1 GND_PWR; RaspberryPi_TX; RaspberryPi_RX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

Autor: Pol Camprubí
Tutora: Marta Tarrés Alimentació i distribució de potència

Sheet: /
File: Esquema elèctric.kicad_sch
Title:
KiCad E.D.A. 10.0.4

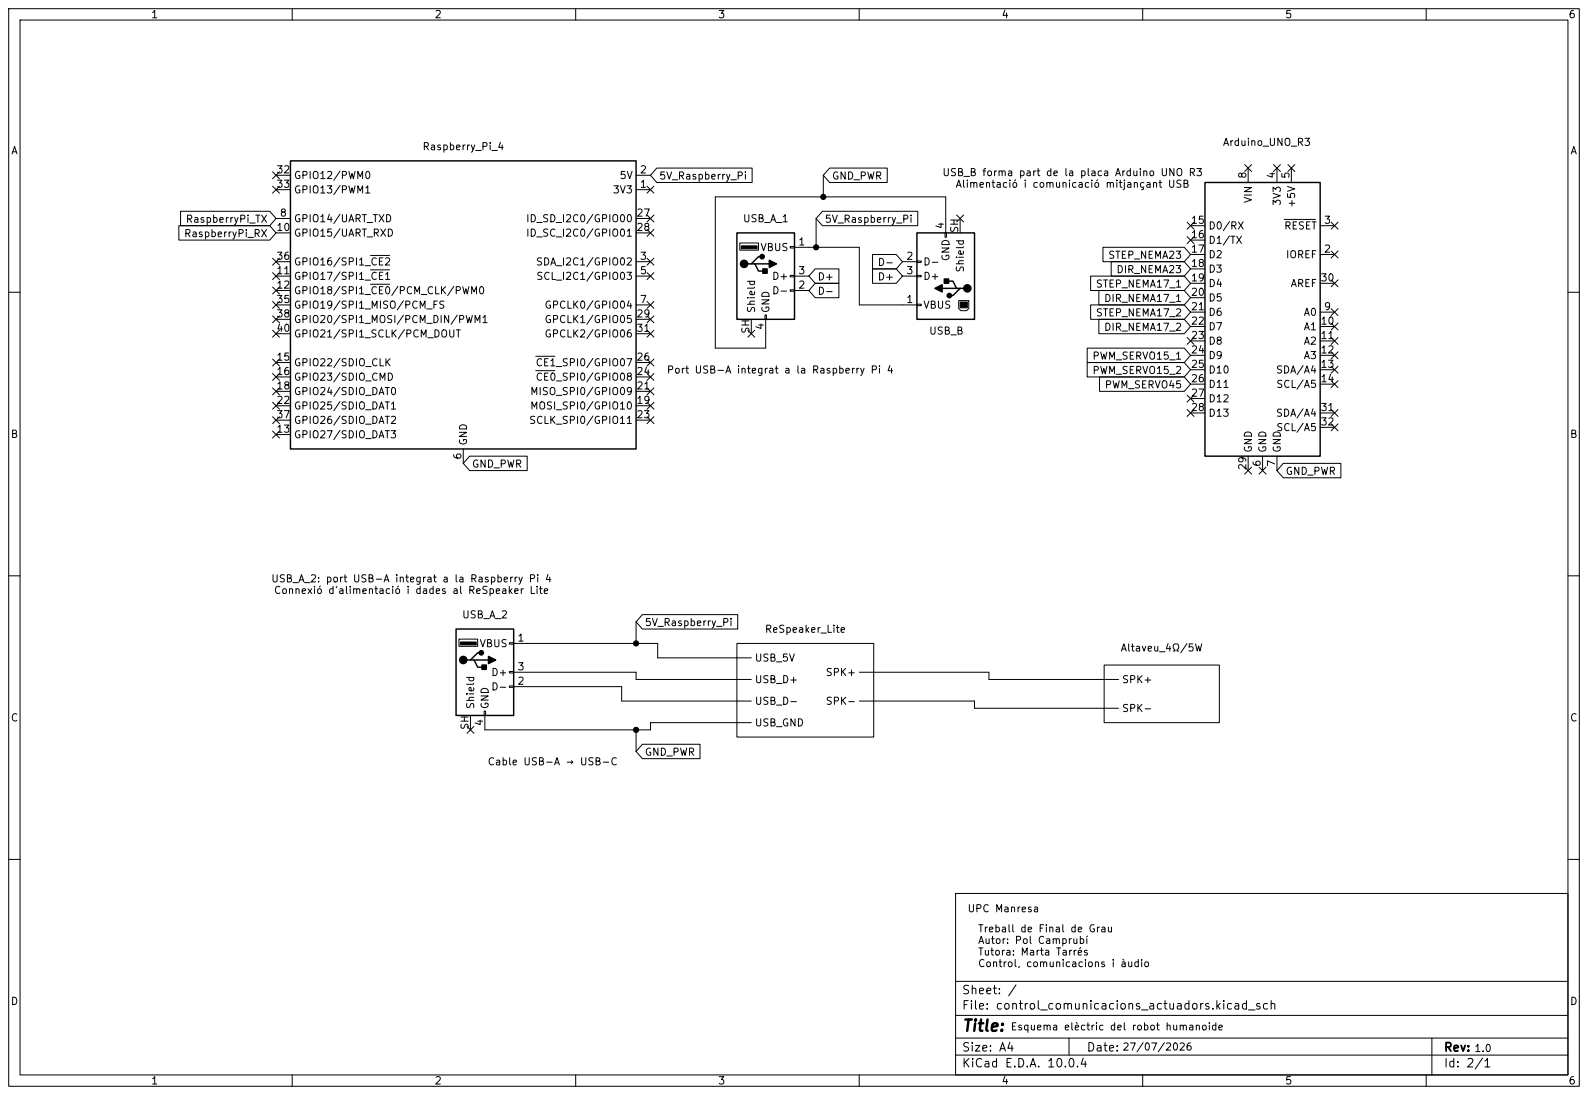
[picture p184: page 2]

USB_B forma part de la placa Arduino UNO R3
Alimentació i comunicació mitjançant USB

Port USB-A integrat a la Raspberry Pi 4

Tutora: Marta Tarrés Control, comunicacions i àudio USB_A_2: port USB-A integrat a la Raspberry Pi 4 Connexió d’alimentació i dades al ReSpeaker Lite Cable USB-A → USB-C

Treball de Final de Grau
Autor: Pol Camprubí

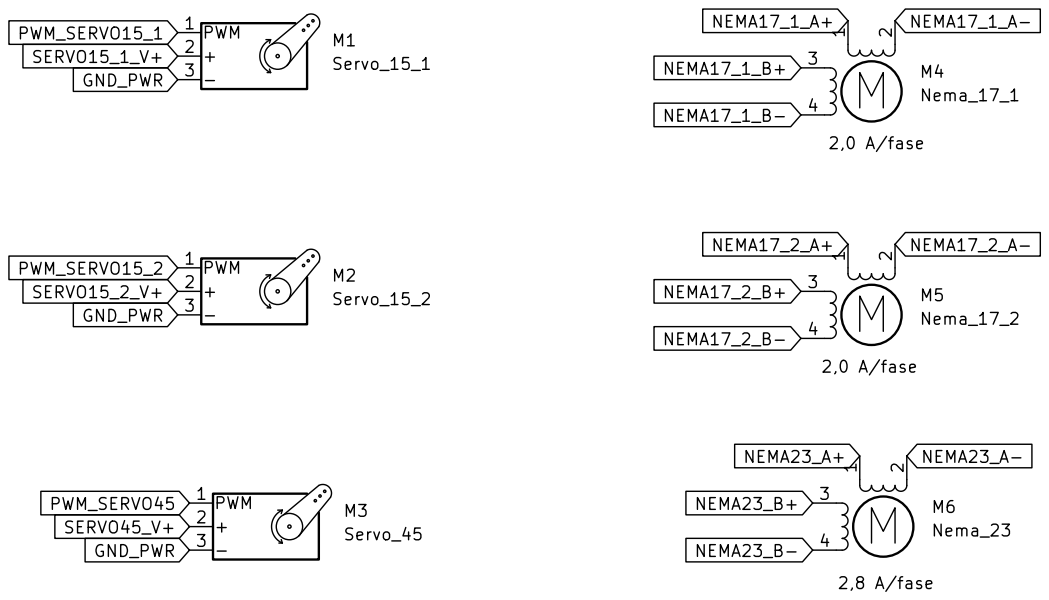
[picture p185: page 3]
D Date:; Title:; File: motors_i_servomotors_(página_3).kicad_sch; Sheet: /; M4 Nema_17_1 PWM 1 +; Servo_45; M6 Nema_23; M5 Nema_17_2 PWM 1 +; Servo_15_2 PWM 1 + 2 -; Servo_15_1; NEMA17_2_A-; NEMA17_1_A-; NEMA23_B-; NEMA23_B+; NEMA23_A+; NEMA23_A-; NEMA17_2_B-; PWM_SERVO45 GND_PWR; NEMA17_2_B+; GND_PWR; SERVO45_V+; NEMA17_1_B+; NEMA17_1_B-; NEMA17_1_A+; NEMA17_2_A+; SERVO15_1_V+; PWM_SERVO15_2 PWM_SERVO15_1 GND_PWR; SERVO15_2_V+; Esquema elèctric del robot humanoide 01/08/2026; 2,0 A/fase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

Tutora: Marta Tarrés Motors i servomotors UPC Manresa
Treball de Final de Grau
Autor: Pol Camprubí
