quibot-dev/QuiBot_IA-3Dmechatronic/hardware/electronics/Esquema elèctric.kicad_sch

## KiCad design hardware/electronics/Esquema elèctric.kicad_sch (2026-10-06)

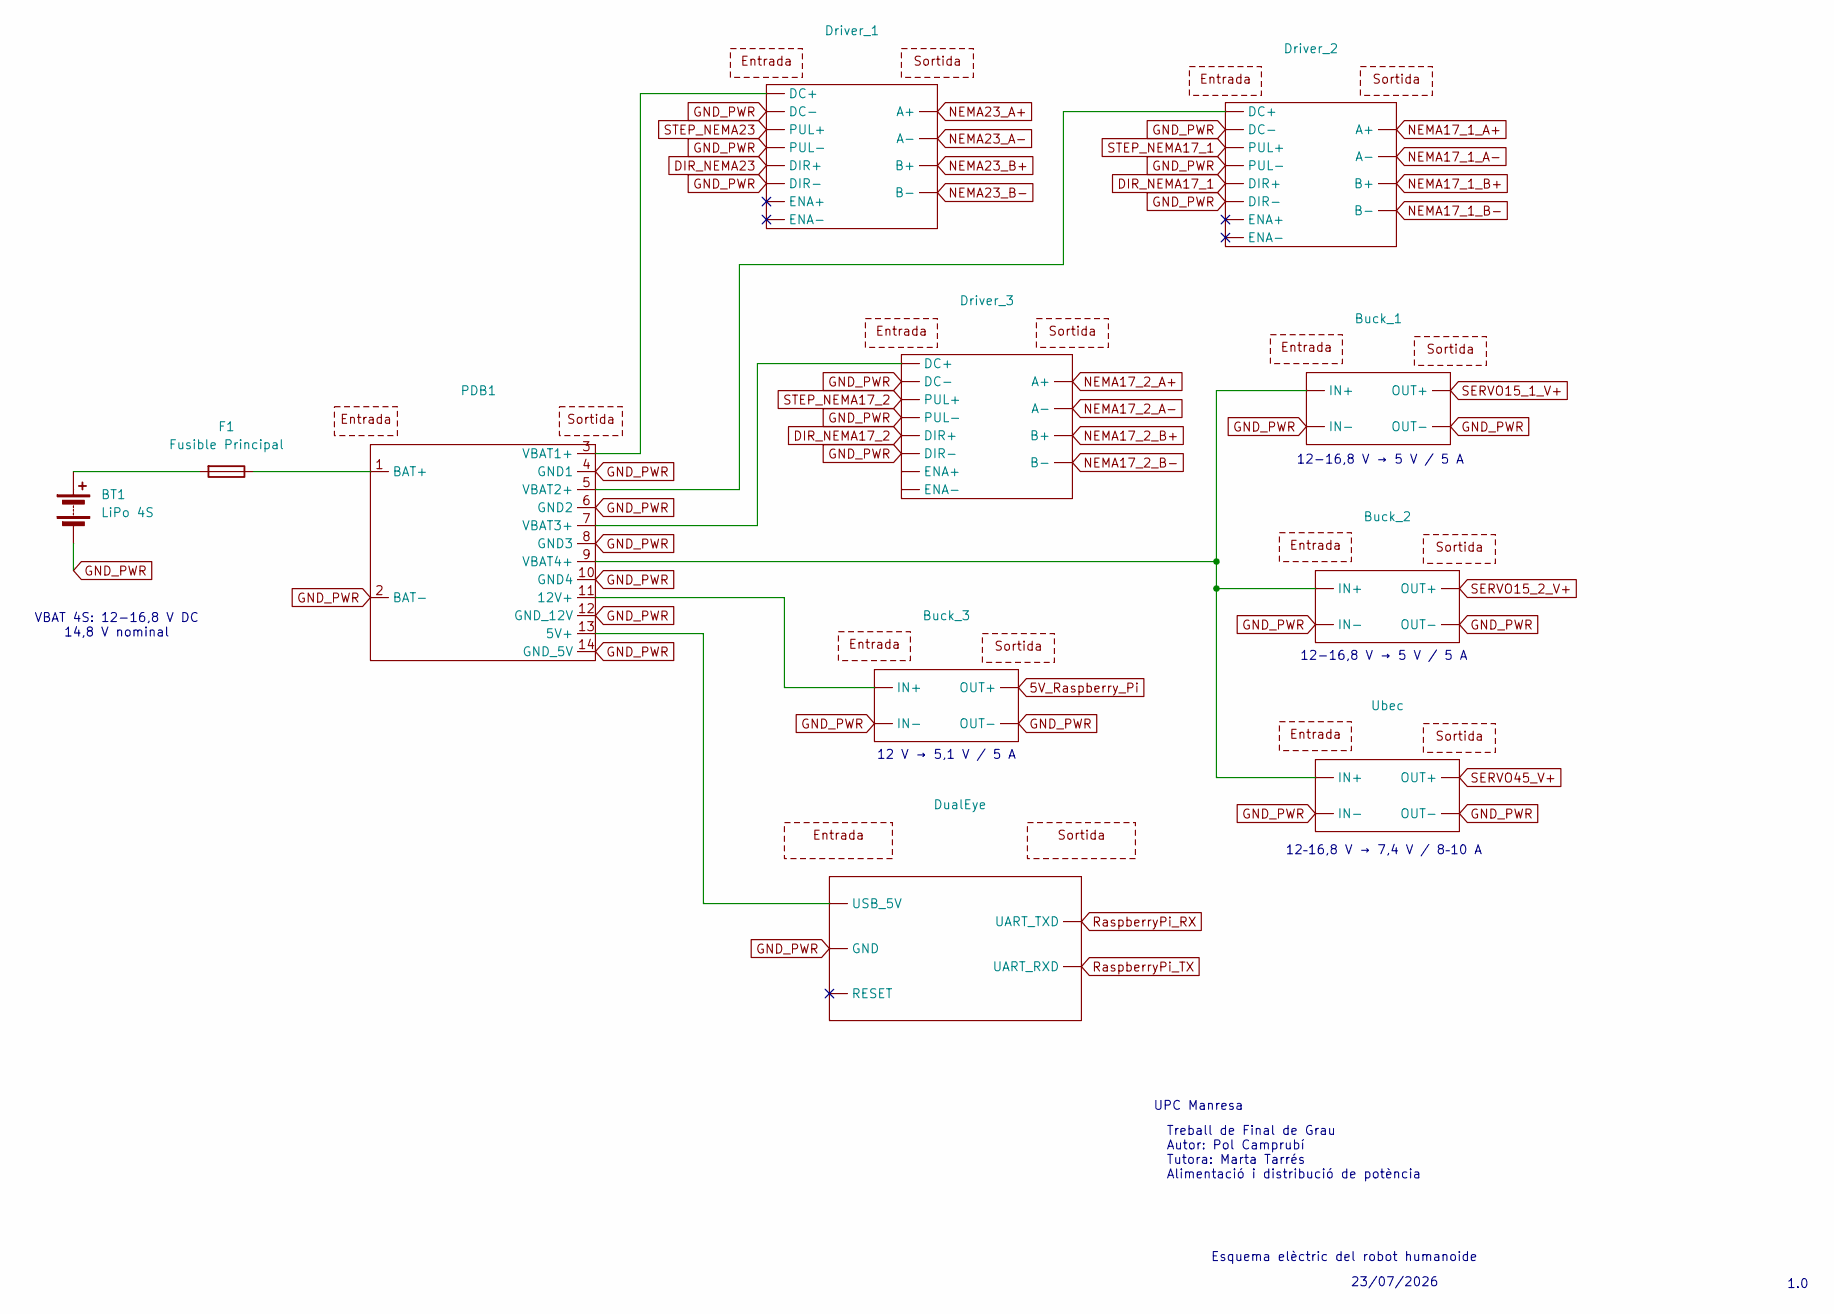
[picture p186: schematic Esquema elèctric.kicad_sch]

Parts:
BT1: LiPo 4S
Buck_1, Buck_2, Buck_3: (no value)
Driver_1, Driver_2, Driver_3: (no value)
DualEye: (no value)
F1: Fusible Principal
PDB1: (no value)
Ubec: (no value)

Connections:
5V_Raspberry_Pi: Buck_3.
DIR_NEMA17_1: Driver_2.
DIR_NEMA17_2: Driver_3.
DIR_NEMA23: Driver_1.
GND_PWR: BT1.2 (-), Buck_1., Buck_2., Buck_3., Driver_1., Driver_2., Driver_3., DualEye., PDB1.2 (BAT-), PDB1.4 (GND1), PDB1.6 (GND2), PDB1.8 (GND3), PDB1.10 (GND4), PDB1.12 (GND_12V), PDB1.14 (GND_5V), Ubec.
NEMA17_1_A+: Driver_2.
NEMA17_1_A-: Driver_2.
NEMA17_1_B+: Driver_2.
NEMA17_1_B-: Driver_2.
NEMA17_2_A+: Driver_3.
NEMA17_2_A-: Driver_3.
NEMA17_2_B+: Driver_3.
NEMA17_2_B-: Driver_3.
NEMA23_A+: Driver_1.
NEMA23_A-: Driver_1.
NEMA23_B+: Driver_1.
NEMA23_B-: Driver_1.
unnamed: BT1.1 (+), F1.2
unnamed: Buck_1., Buck_2., PDB1.9 (VBAT4+), Ubec.
unnamed: Buck_3., PDB1.11 (12V+)
unnamed: Driver_1., PDB1.3 (VBAT1+)
unnamed: Driver_2., PDB1.5 (VBAT2+)
unnamed: Driver_3., PDB1.7 (VBAT3+)
unnamed: DualEye., PDB1.13 (5V+)
unnamed: F1.1, PDB1.1 (BAT+)
RaspberryPi_RX: DualEye.
RaspberryPi_TX: DualEye.
SERVO15_1_V+: Buck_1.
SERVO15_2_V+: Buck_2.
SERVO45_V+: Ubec.
STEP_NEMA17_1: Driver_2.
STEP_NEMA17_2: Driver_3.
STEP_NEMA23: Driver_1.

Notes on the sheet:
12-16,8 V → 5 V / 5 A
Treball de Final de Grau Autor: Pol Camprubí Tutora: Marta Tarrés Alimentació i distribució de potència
12-16,8 V → 5 V / 5 A
12–16,8 V → 7,4 V / 8–10 A
UPC Manresa
1.0
23/07/2026
12 V → 5,1 V / 5 A
VBAT 4S: 12-16,8 V DC 14,8 V nominal
Esquema elèctric del robot humanoide
