quibot-dev/QuiBot_IA-3Dmechatronic/hardware/electronics/control_comunicacions_actuadors.kicad_sch

## KiCad design hardware/electronics/control_comunicacions_actuadors.kicad_sch (2026-10-06)

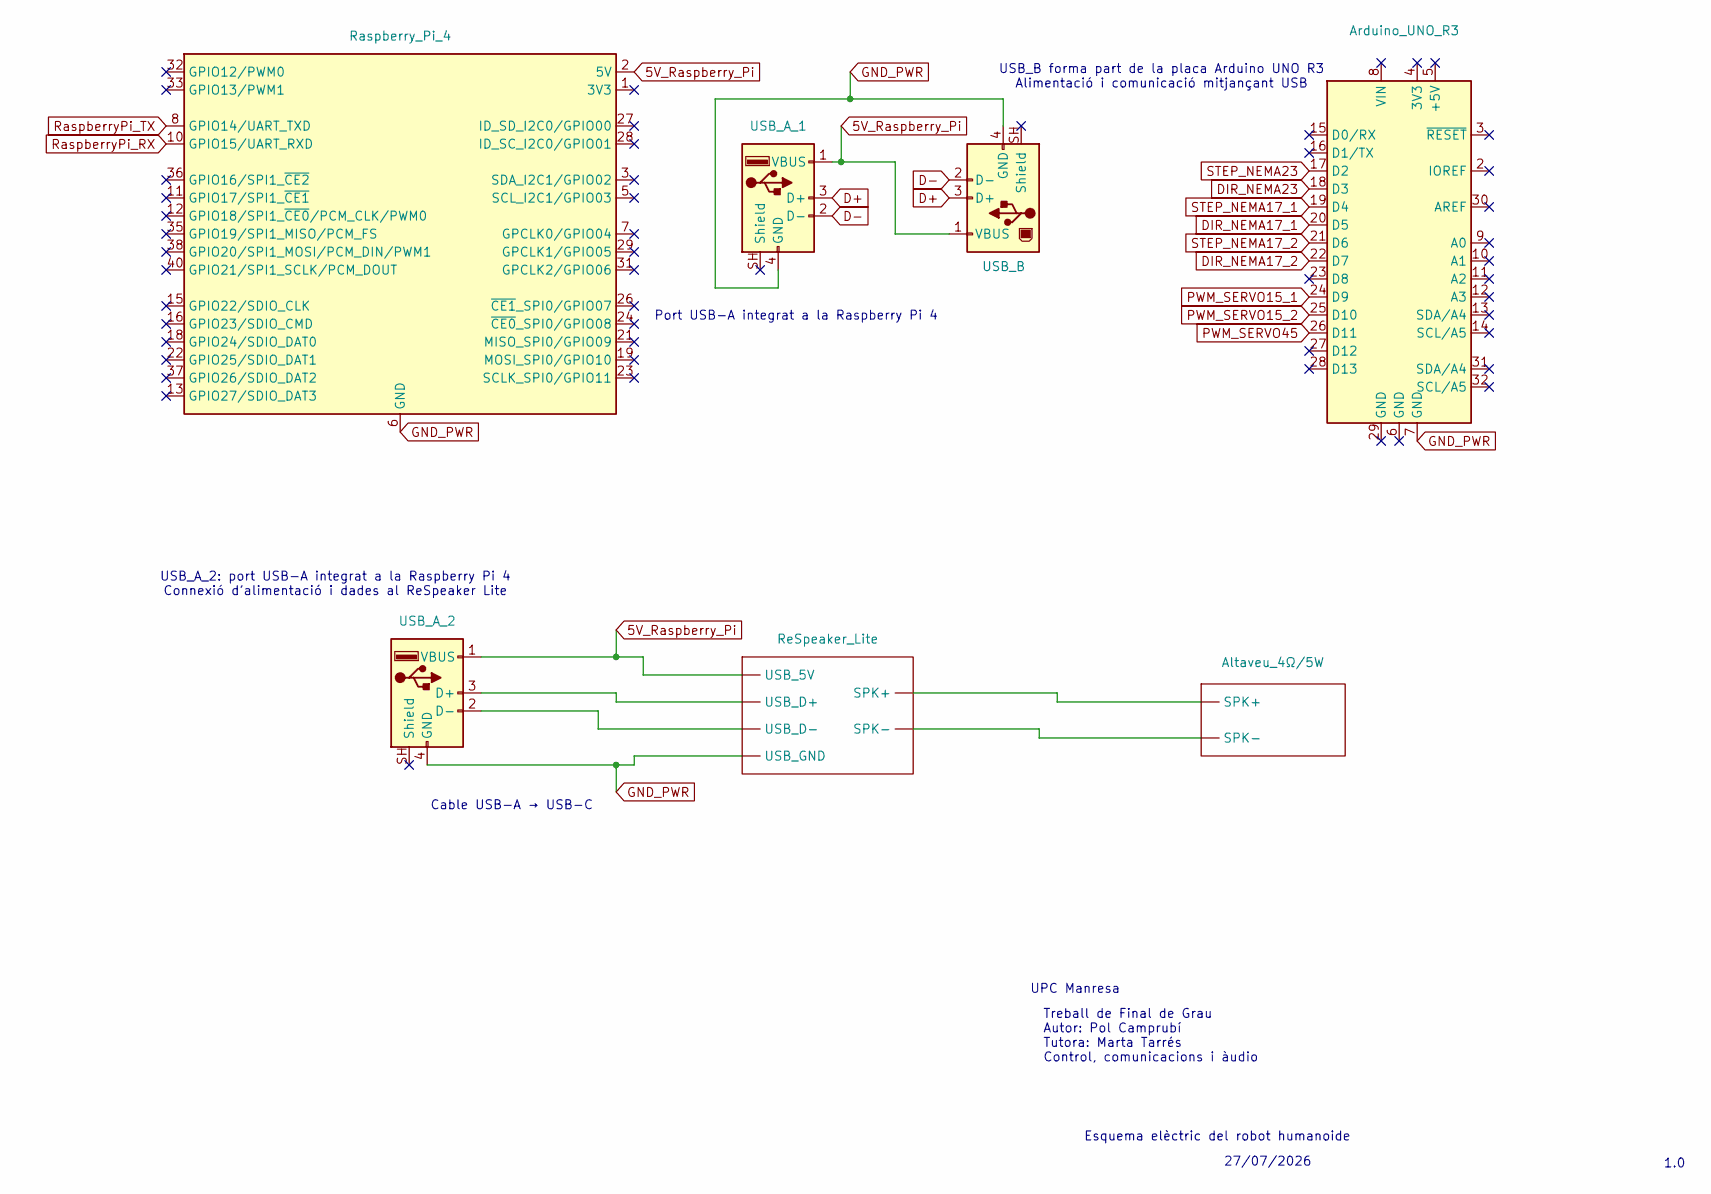
[picture p187: schematic control_comunicacions_actuadors.kicad_sch]

Parts:
A1: Arduino_UNO_R3
Altaveu_4Ω/5W: (no value)
J1: Raspberry_Pi_4
J2: USB_B
J3: USB_A_2
J4: USB_A_1
ReSpeaker_Lite: (no value)

Connections:
5V_Raspberry_Pi: J1.2 (5V), J1.4 (5V), J2.1 (VBUS), J3.1 (VBUS), J4.1 (VBUS), ReSpeaker_Lite.
D+: J2.3 (D+), J4.3 (D+)
D-: J2.2 (D-), J4.2 (D-)
DIR_NEMA17_1: A1.20 (D5)
DIR_NEMA17_2: A1.22 (D7)
DIR_NEMA23: A1.18 (D3)
GND_PWR: A1.7 (GND), J1.6 (GND), J1.9 (GND), J1.14 (GND), J1.20 (GND), J1.25 (GND), J1.30 (GND), J1.34 (GND), J1.39 (GND), J2.4 (GND), J3.4 (GND), J4.4 (GND), ReSpeaker_Lite.
unnamed: Altaveu_4Ω/5W., ReSpeaker_Lite.
unnamed: J1.1 (3V3), J1.17 (3V3)
unnamed: J3.2 (D-), ReSpeaker_Lite.
unnamed: J3.3 (D+), ReSpeaker_Lite.
PWM_SERVO15_1: A1.24 (D9)
PWM_SERVO15_2: A1.25 (D10)
PWM_SERVO45: A1.26 (D11)
RaspberryPi_RX: J1.10 (GPIO15/UART_RXD)
RaspberryPi_TX: J1.8 (GPIO14/UART_TXD)
STEP_NEMA17_1: A1.19 (D4)
STEP_NEMA17_2: A1.21 (D6)
STEP_NEMA23: A1.17 (D2)

Notes on the sheet:
Treball de Final de Grau Autor: Pol Camprubí Tutora: Marta Tarrés Control, comunicacions i àudio
Cable USB-A → USB-C
UPC Manresa
27/07/2026
USB_A_2: port USB-A integrat a la Raspberry Pi 4 Connexió d’alimentació i dades al ReSpeaker Lite
Esquema elèctric del robot humanoide
USB_B forma part de la placa Arduino UNO R3 Alimentació i comunicació mitjançant USB
1.0
Port USB-A integrat a la Raspberry Pi 4
