quibot-dev/QuiBot_IA-3Dmechatronic/hardware/electronics/motors_i_servomotors_(página_3).kicad_sch

## KiCad design hardware/electronics/motors_i_servomotors_(página_3).kicad_sch (2026-10-06)

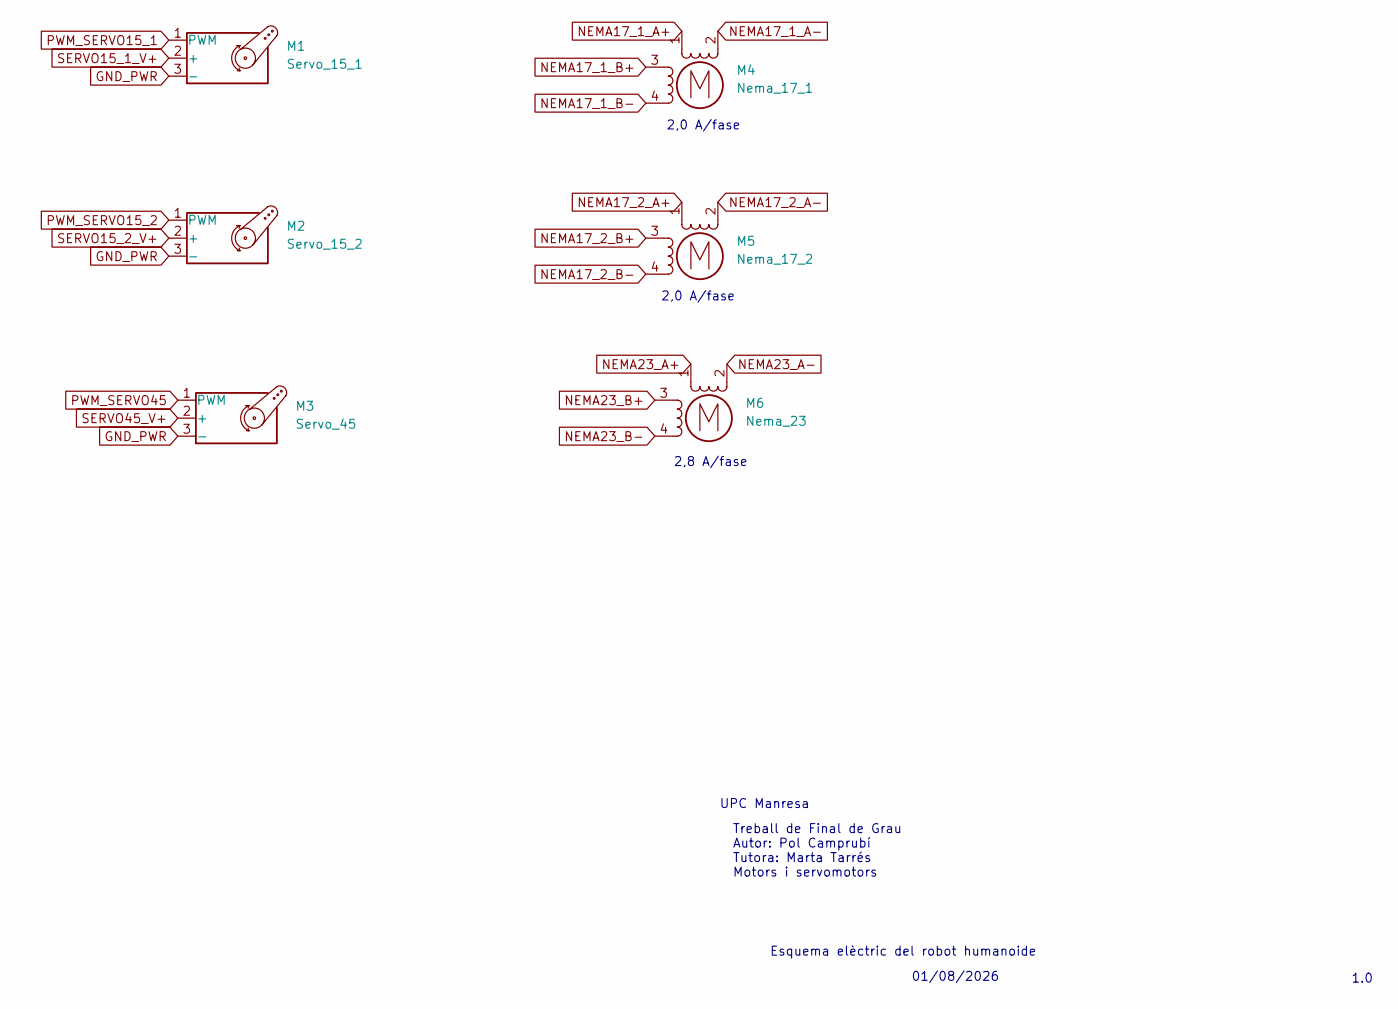
[picture p188: schematic motors_i_servomotors_(página_3).kicad_sch]

Parts:
M1: Servo_15_1
M2: Servo_15_2
M3: Servo_45
M4: Nema_17_1
M5: Nema_17_2
M6: Nema_23

Connections:
GND_PWR: M1.3 (-), M2.3 (-), M3.3 (-)
NEMA17_1_A+: M4.1
NEMA17_1_A-: M4.2 (-)
NEMA17_1_B+: M4.3
NEMA17_1_B-: M4.4
NEMA17_2_A+: M5.1
NEMA17_2_A-: M5.2 (-)
NEMA17_2_B+: M5.3
NEMA17_2_B-: M5.4
NEMA23_A+: M6.1
NEMA23_A-: M6.2 (-)
NEMA23_B+: M6.3
NEMA23_B-: M6.4
PWM_SERVO15_1: M1.1 (PWM)
PWM_SERVO15_2: M2.1 (PWM)
PWM_SERVO45: M3.1 (PWM)
SERVO15_1_V+: M1.2 (+)
SERVO15_2_V+: M2.2 (+)
SERVO45_V+: M3.2 (+)

Notes on the sheet:
UPC Manresa
Esquema elèctric del robot humanoide
2,8 A/fase
1.0
2,0 A/fase
Treball de Final de Grau Autor: Pol Camprubí Tutora: Marta Tarrés Motors i servomotors
01/08/2026
