quibot-dev/QuiBot_IA-3Dmechatronic/(commit log)

2026-10-04 Create README.md
    Aquí es troben els fitxers STL del robot.
2026-10-04 Create README.md
    Aquest llistat és de tot el material que s'ha de comprar per poder fabricar el robot.
2026-10-06 Add Arduino motion firmware
2026-10-06 Add Raspberry Pi control software
2026-10-06 Afegeix la configuració d'exemple
2026-10-06 Imatge principal de Quibot
2026-10-06 Actualitza el README del projecte
2026-10-06 Afegeix els esquemes electrònics de Quibot
2026-10-06 Actualitza la documentació de l'electrònica
